EmielV2002/FRDM_MCXx_SensHat/README.md

# FRDM_MCXx_SensHat
 A hat with sensors and actutors for the FRDM-MCXA153 and FRDM-MCXN947 development boards by NXP.
