EmielV2002/FRDM_MCXx_SensHat/PCB/FRDM-MCXA153__Shield__Template-Original/readme.md

# FRDM-MCXA153__Shield__Template
This repo has been initialized with make_pcb.py
## Folder structure 
### /tracks
  Altium & Kicad source files organized by version
### /mixdowns
  Staging area for build documentation organized by version.  The target for the outjob
### /golden
  .zip files with official data for fab organized by version.
