EmielV2002/FRDM_MCXx_SensHat/Docs/Docs V3.x/Orderlist_FRDM-MCXx_Shield_V3.0.xlsx

Type: | Reference: | Value: | Package: | Price pp: | Quantity: | Price total | PCBs: | Price pp: | Total amount: | Extra | Price total: | Link:
Capacitor | C1, C2, C5, C6, C7, C8, C10, C11 | 100nF | 0805 | €0.09 | 9 | €0.84 | 30 | €0.04 | 300 | 0 | €10.50 | https://nl.mouser.com/ProductDetail/KEMET/C0805C104J8RACTU
Capacitor | C3, C4 | 10nF | 0805 | €0.09 | 1 | €0.09 | 30 | €0.05 | 40 | 10 | €2.16 | https://nl.mouser.com/ProductDetail/KEMET/C0805C103K5RACTU
Capacitor | C9 | 10uF | 0805 | €0.09 | 1 | €0.09 | 30 | €0.03 | 40 | 10 | €1.28 | https://nl.mouser.com/ProductDetail/Samsung-Electro-Mechanics/CL21A106KOQNNNF?qs=yOVawPpwOwkT2GN1K0OOyQ%3D%3D
Resistor | R1, R3, R4, R8, R9 | 10k | 0805 | €0.09 | 5 | €0.45 | 30 | €0.01 | 180 | 30 | €1.80 | https://nl.mouser.com/ProductDetail/SEI-Stackpole/RMCF0805FT10K0?qs=IreZ0J%252BReG3LOHc8zdDe6Q%3D%3D
Resistor | R2, R5, R6 | 1k | 0805 | €0.11 | 3 | €0.32 | 30 | €0.01 | 120 | 30 | €0.96 | https://nl.mouser.com/ProductDetail/Kamaya/RMC1-10K1001FTP?qs=JZJGM%252BYuqVpN6T%252B5jtun0w%3D%3D
Resistor | R7 | 470 | 0805 | €0.09 | 1 | €0.09 | 30 | €0.07 | 40 | 10 | €2.92 | https://nl.mouser.com/ProductDetail/Welwyn-Components-TT-Electronics/WCR0805-470RFI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
Diode | D1, D2, D3, D4, D5, D6, D7, D8 | RED | 0805 | €0.18 | 8 | €1.42 | 30 | €0.14 | 300 | 0 | €42.00 | https://nl.mouser.com/ProductDetail/Wurth-Elektronik/150080RS75000?qs=LlUlMxKIyB2jdCo7bnfgew%3D%3D
Diode | D9, D10, D11, D12, D13 | SP0503BAHT | SOT-143 | €0.61 | 5 | €3.07 | 30 | €0.42 | 180 | 30 | €75.42 | https://nl.mouser.com/ProductDetail/Littelfuse/SP0503BAHTG?qs=uD%2FdkN7XIa0NTYXwHdELYA%3D%3D
Diode | D14, D15, D16 | SK6812 | SK6812_PLCC4_5.0x5.0mm_P3.2mm | €0.42 | 3 | €1.26 | 30 | €0.42 | 100 | 10 | €41.90 | https://nl.mouser.com/ProductDetail/Adafruit/1655?qs=GURawfaeGuATdkjqVQs49g%3D%3D
IC | U1 | 74HC595 | TSSOP-16 | €0.35 | 1 | €0.35 | 30 | €0.26 | 40 | 10 | €10.44 | https://nl.mouser.com/ProductDetail/Nexperia/74HC595PW-Q100118?qs=1sbE9T7hb3aHrTORCcEuDg%3D%3D
IC | U2 | M95010-RMN6TP | SOIC-8 | €0.26 | 1 | €0.26 | 30 | €0.24 | 40 | 10 | €9.52 | https://nl.mouser.com/ProductDetail/STMicroelectronics/M95010-RMN6TP?qs=6hSH1YZbOIgK0xa%252BHaDUCw%3D%3D
IC | U3 | LM35-D | SOIC-8 | €2.22 | 1 | €2.22 | 30 | €1.40 | 40 | 10 | €56.00 | https://nl.mouser.com/ProductDetail/Texas-Instruments/LM35DMX-NOPB?qs=QbsRYf82W3EWENRCd3%252BcOw%3D%3D
Switch | SW1 | EC12D1524406 | EC12D1564404 | €1.92 | 1 | €1.92 | 30 | €1.63 | 40 | 10 | €65.20 | https://nl.mouser.com/ProductDetail/Alps-Alpine/EC12D1524406?qs=YMSFtX0bdJBTxNo8FqqMqg%3D%3D
Test hook | TP1, TP2, TP3, TP4, TP5, TP6 | 5001 | 5000 | €0.34 | 6 | €2.06 | 30 | €0.27 | 190 | 10 | €51.30 | https://nl.mouser.com/ProductDetail/Keystone-Electronics/5001?qs=q0tsjPZWdm%2FW0vdr%2FwowKg%3D%3D
Resistor | RN2, RN3 | 1k | 4X1206 | €0.39 | 2 | €0.78 | 30 | €0.17 | 70 | 10 | €11.97 | https://nl.mouser.com/ProductDetail/YAGEO/YC324-FK-071KL?qs=Yg3NzgXT575QDUkzeq0DWw%3D%3D
Resistor | RN1 | 4,7k | 4X1206 | €0.42 | 1 | €0.42 | 30 | €0.17 | 40 | 10 | €6.60 | https://nl.mouser.com/ProductDetail/YAGEO/YC324-JK-074K7L?qs=8cPjvKtxWv6TVoP8DHxSjw%3D%3D
Oled | SSD1306 | SSD1306 | - | €7.00 | 1 | €7.00 | 30 | €6.00 | 35 | 5 | €210.00 | https://www.tinytronics.nl/en/displays/oled/0.96-inch-oled-display-128*64-pixels-white-i2c
Total: |  |  |  | €14.69 | 50 | €22.65 | 30 |  | 1500 |  | €599.97
 | Let op!: SK6182 worden per 10 verpakt. Het gaat hier om 3 leds, niet 3 verpakkingen!
Prijs per pcb | €22.65
Prijs 30 pcbs | €20.00
