EmielV2002/FRDM_MCXx_SensHat/Solder stencil tool/tool assem.SLDASM

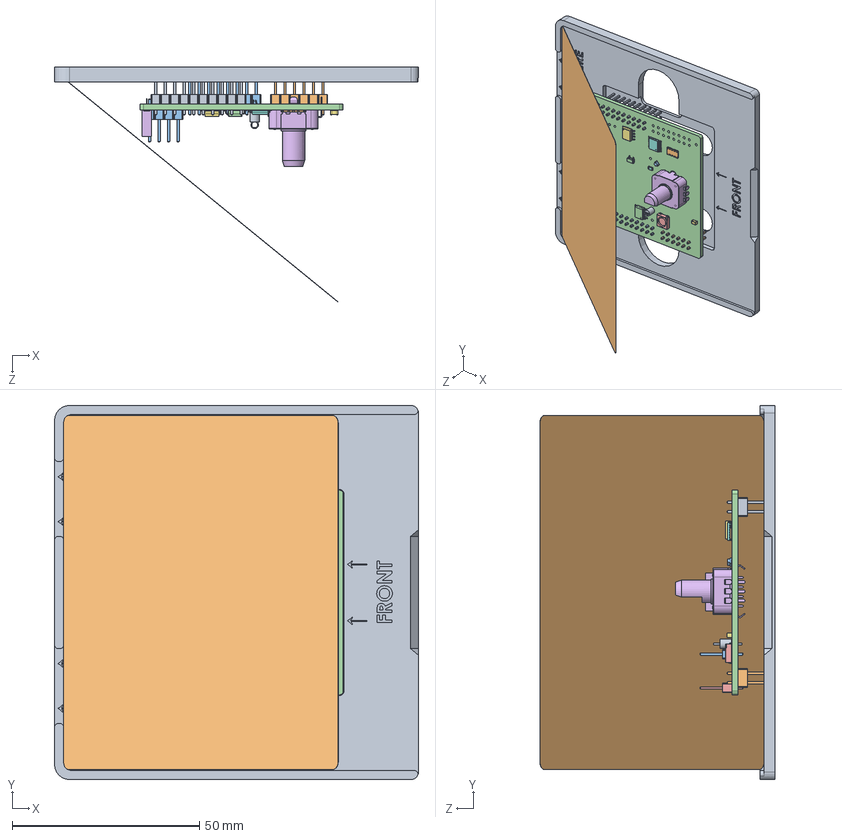
[picture p1: CAD file, 2024-06-22]
Solder stencil tool/tool assem.SLDASM
97.3 x 100.0 x 62.9 mm
Tool
Stencil
FRDM-MCXx_Shield_V3.0_PCB.step
