EmielV2002/FRDM_MCXx_SensHat/PCB/3D/3386P.step

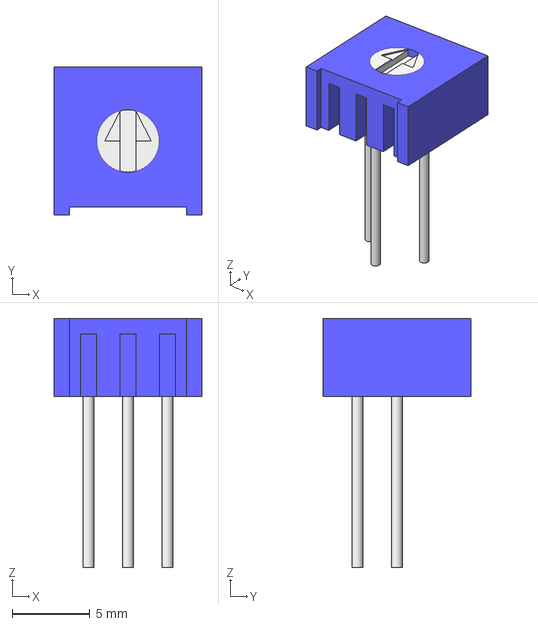
[picture p2: CAD file, 2024-06-17]
PCB/3D/3386P.step
9.50 x 9.50 x 16.0 mm
