EmielV2002/FRDM_MCXx_SensHat/PCB/3D/Rotary Encoder.step

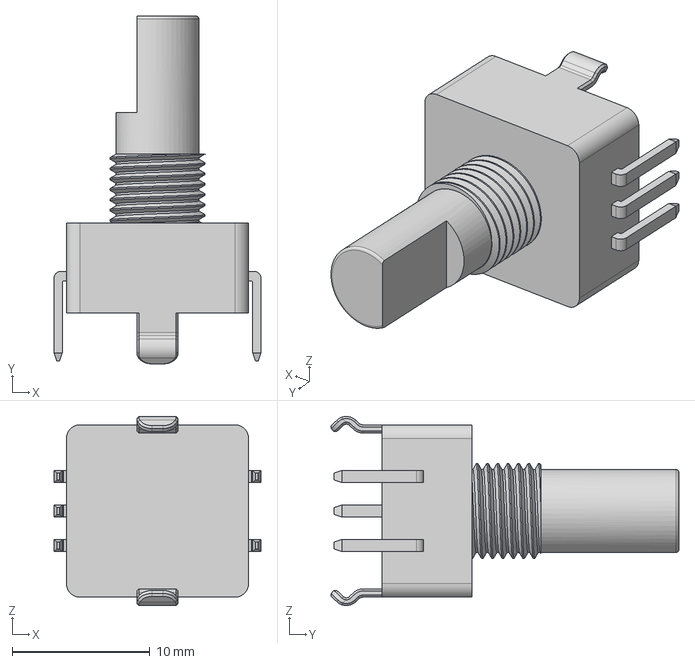
[picture p3: CAD file, 2024-06-17]
PCB/3D/Rotary Encoder.step
15.0 x 25.2 x 13.7 mm
