EmielV2002/FRDM_MCXx_SensHat/Solder stencil tool/Stencil.SLDPRT

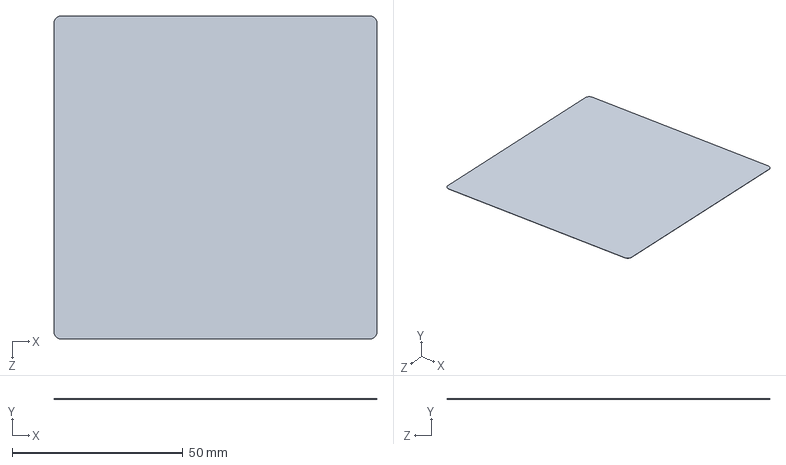
[picture p4: CAD file, 2024-06-20]
Solder stencil tool/Stencil.SLDPRT
94.7 x 0.1 x 94.7 mm
