EmielV2002/FRDM_MCXx_SensHat/PCB/3D/SHT31_DFN8.stp

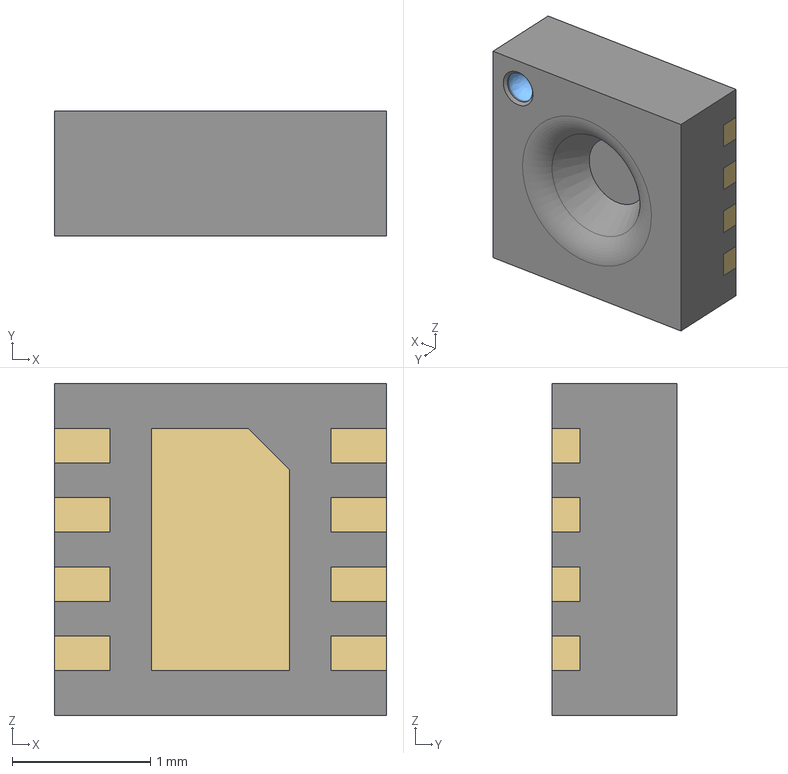
[picture p5: CAD file, 2024-06-17]
PCB/3D/SHT31_DFN8.stp
2.40 x 0.9 x 2.40 mm
