EmielV2002/FRDM_MCXx_SensHat/Solder stencil tool/Tool.SLDPRT

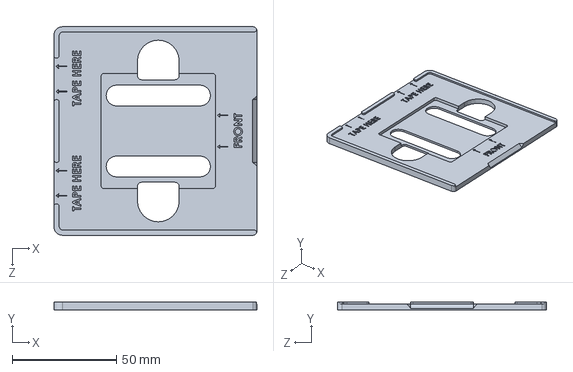
[picture p6: CAD file, 2024-06-20]
Solder stencil tool/Tool.SLDPRT
97.3 x 4.00 x 100.0 mm
