EmielV2002/FRDM_MCXx_SensHat/(list of files, cad)

Other CAD files:
Solder stencil tool/Tool.STL
