EmielV2002/FRDM_MCXx_SensHat/Docs/Docs V3.x/hardware diagram V3.x.drawio.pdf

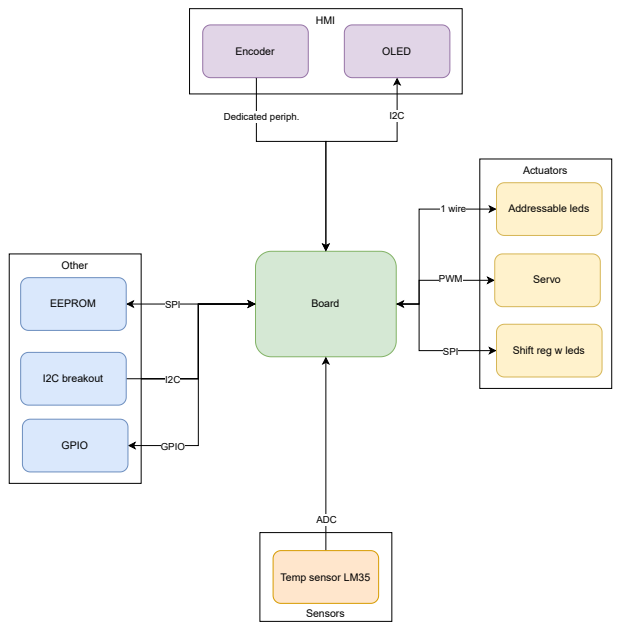
[picture p8: page 1]
HMI; Sensors; Actuators; 1 wire; PWM; Board; ADC; Temp sensor LM35; Addressable leds; OLED; Dedicated periph.; Encoder; SPI; Shift reg w leds; Other; EEPROM; GPIO; Servo; I2C breakout
