EmielV2002/FRDM_MCXx_SensHat/PCB/FRDM-MCXA153__Shield__Template-Original/mixdowns/A/SCH/CCA-10010__SCHEMATICS__A.PDF

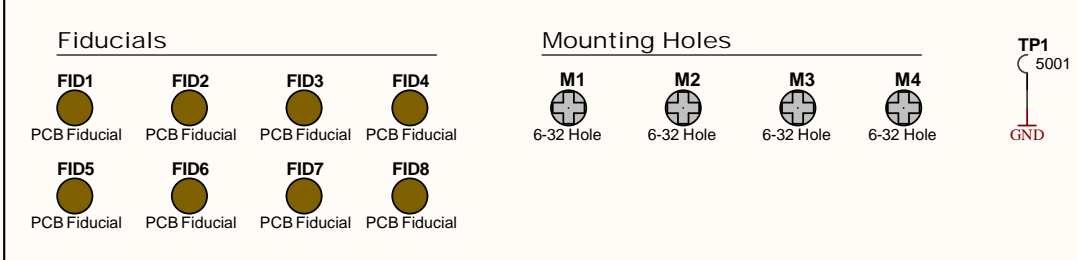
[picture p9: page 1]

Part Numbe r PCB-10010 | PCB Mixdown A | CCA Mixdown
De s cription FR DM-MCXA153__Shield__T e m p l a t e | 3A Date 2023-12-2 6

Engine e r Plexu s | Page 1 o f

TODO:
Add license/copyright symbol here
