EmielV2002/FRDM_MCXx_SensHat/Docs/FRDM-MCXAorN_Hat.drawio.pdf

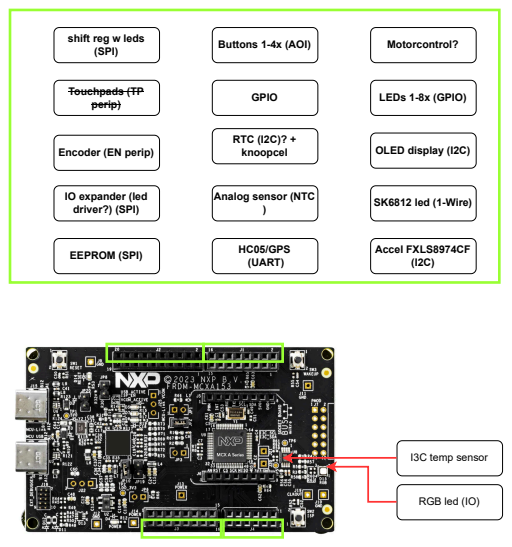
[picture p10: page 1]
I3C temp sensor; OLED display (I2C); SK6812 led (1-Wire); HC05/GPS (UART); Accel FXLS8974CF (I2C); GPIO; LEDs 1-8x (GPIO); Buttons 1-4x (AOI); Motorcontrol? shift reg w leds; (SPI); Touchpads (TP perip); EEPROM (SPI); RTC (I2C)? + knoopcel

Encoder (EN perip)

IO expander (led
driver?) (SPI)

Analog sensor (NTC

RGB led (IO)
