EmielV2002/FRDM_MCXx_SensHat/Docs/Docs V3.x/FRDM-MCXx_Shield_V3.0.pdf

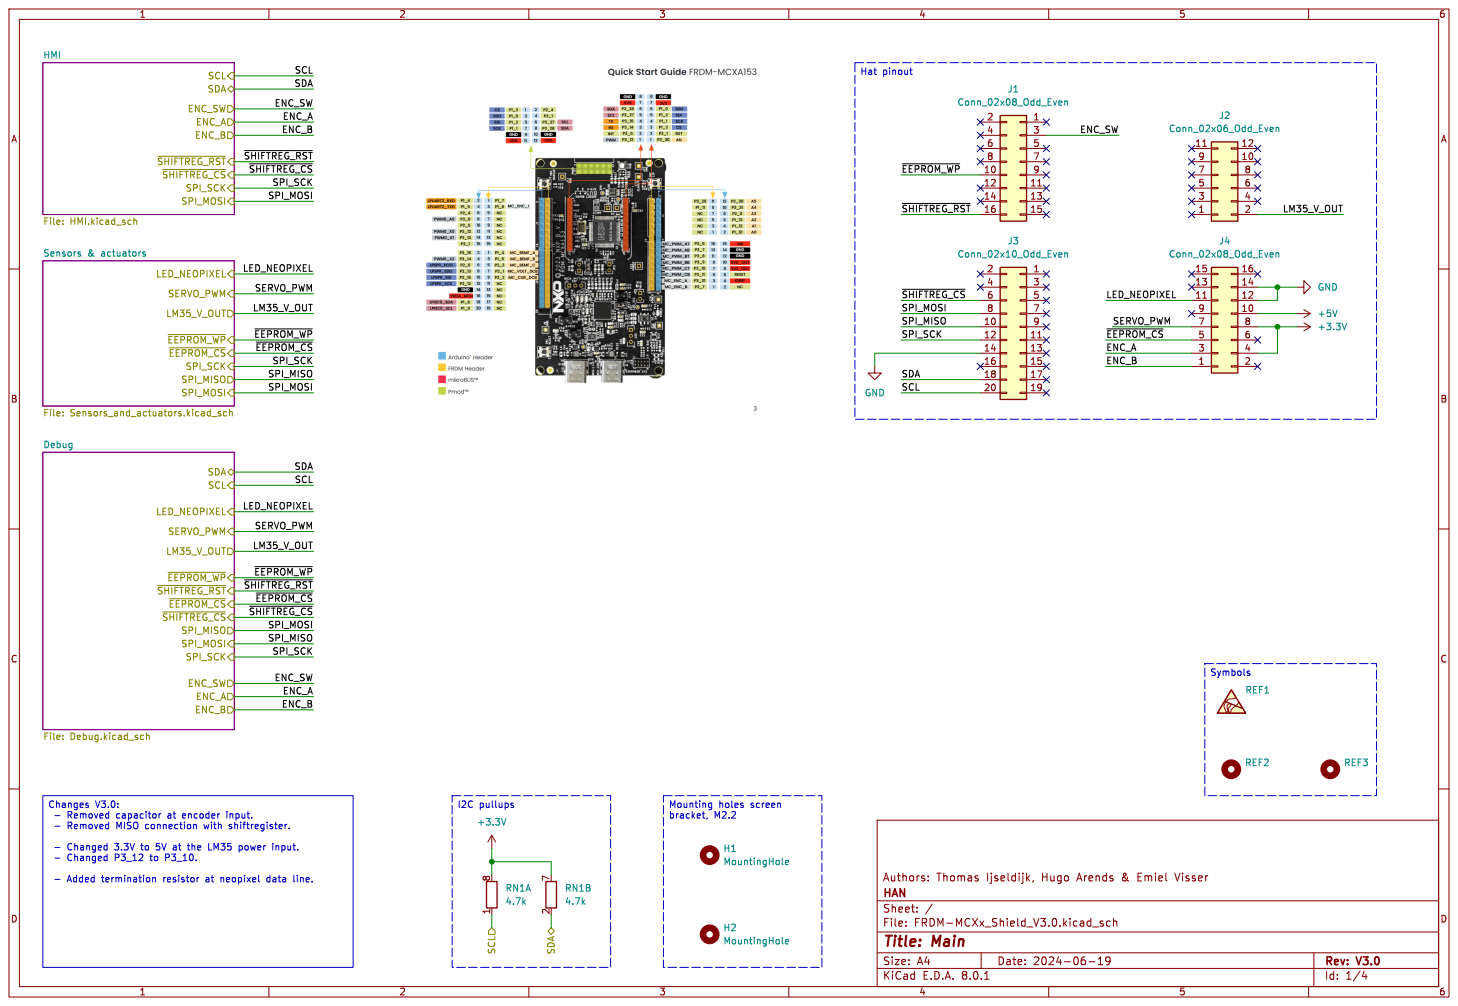
[picture p11: page 1]

File: FRDM-MCXx_Shield_V3.0.kicad_sch Sheet: / HAN

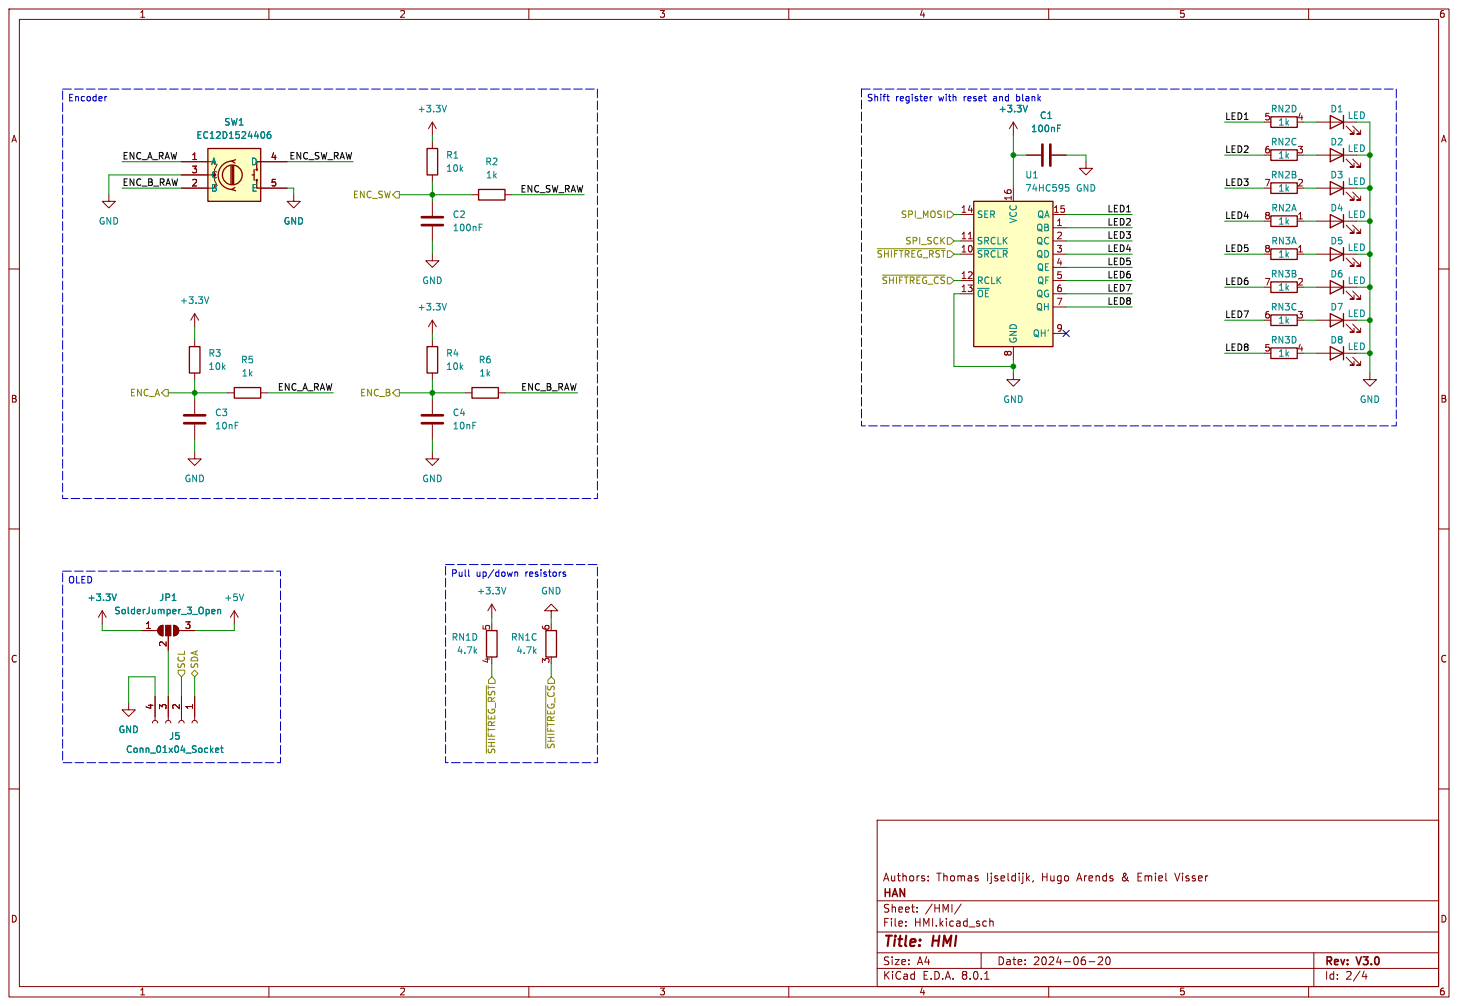
[picture p12: page 2]

Id: 2/4 Title: HMI File: HMI.kicad_sch Sheet: /HMI/ HAN

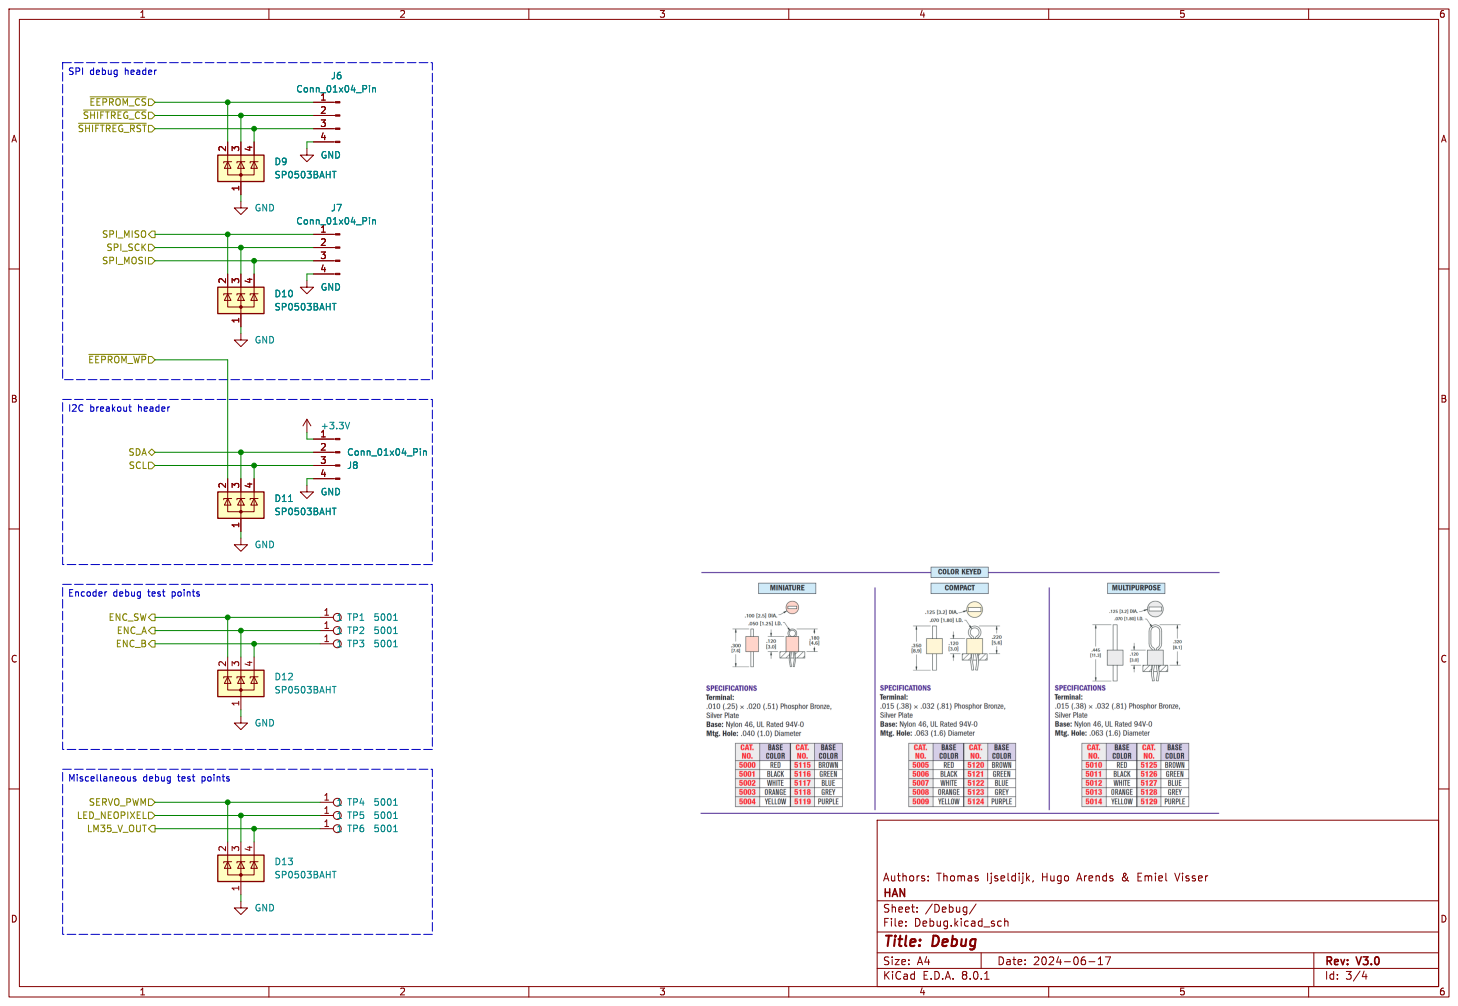
[picture p13: page 3]

File: Debug.kicad_sch Sheet: /Debug/ HAN

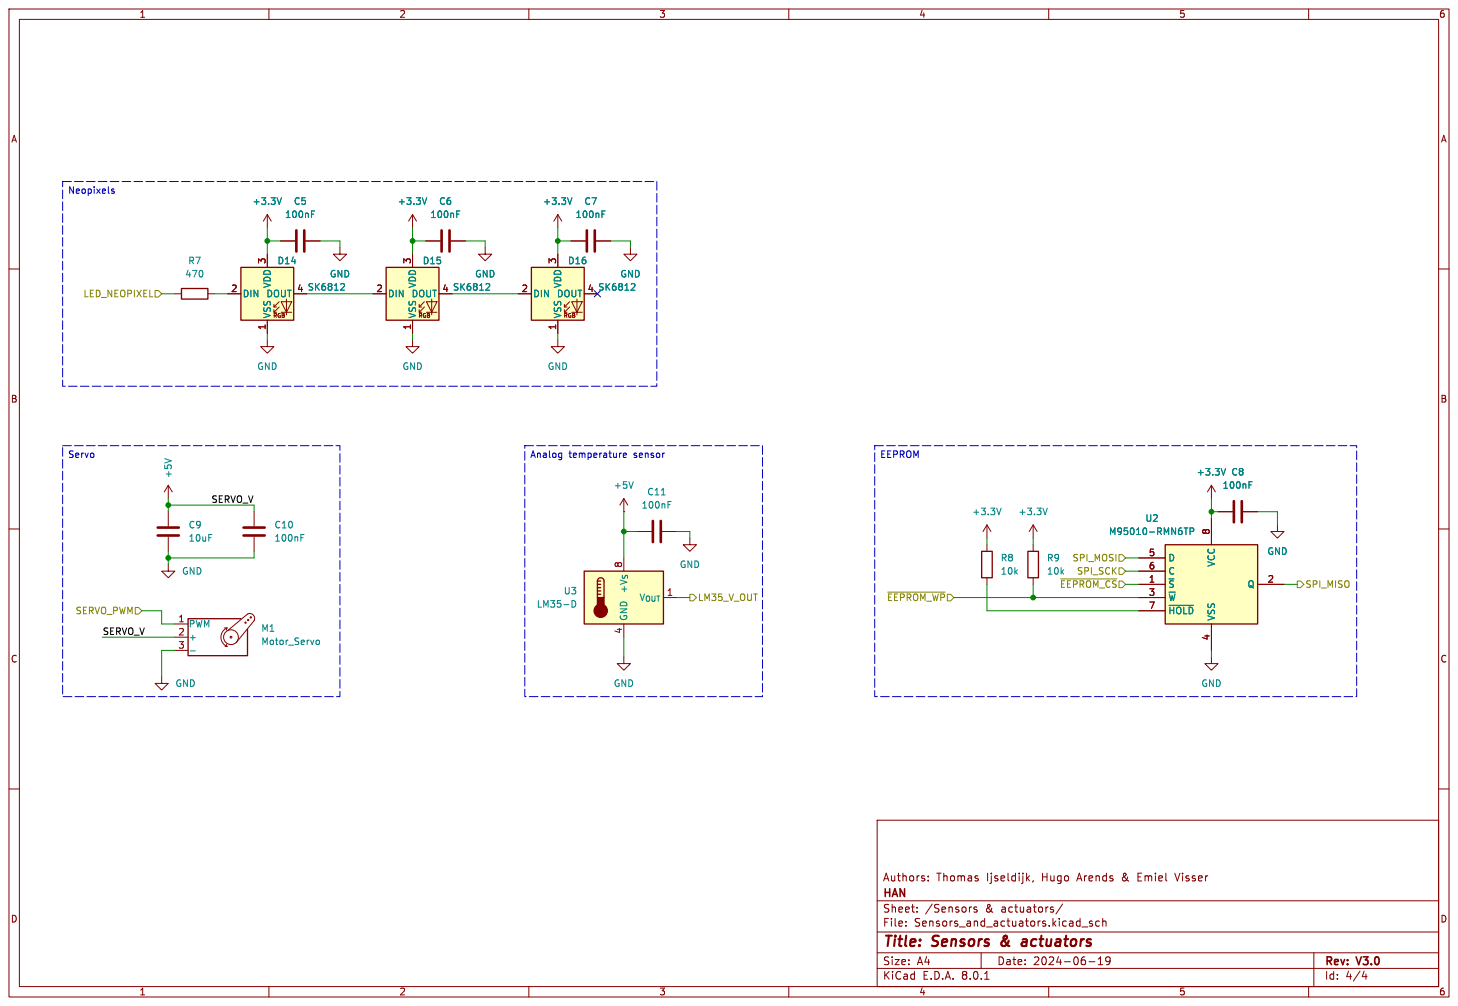
[picture p14: page 4]

8 U2 M95010-RMN6TP VSS RGB 1 DIN 2 VDD

Id: 4/4 Title: Sensors & actuators
