EmielV2002/FRDM_MCXx_SensHat/Docs/Docs V1.x/hardware diagram V1.x.drawio.pdf

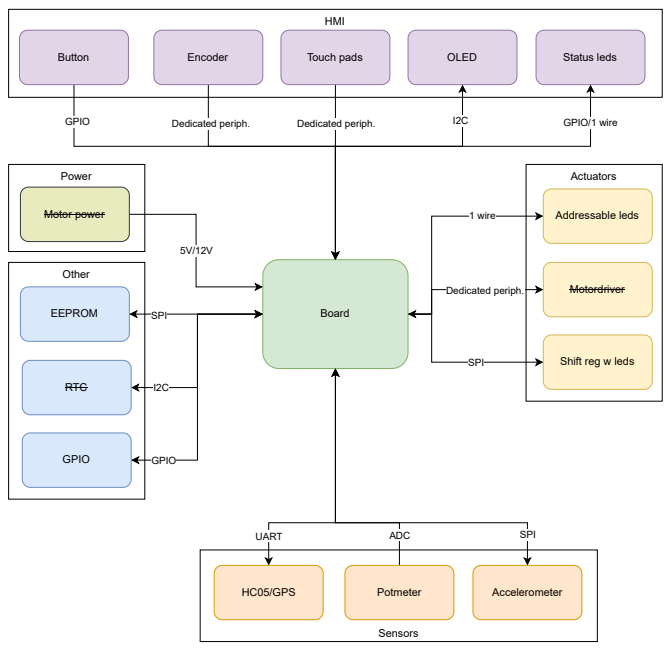
[picture p15: page 1]
HMI; Power; Sensors; Actuators; GPIO/1 wire; 1 wire; Dedicated periph.; Board; Status leds; ADC; Potmeter; Addressable leds; GPIO; Button; Motor power; Motordriver; OLED; Encoder; Touch pads; SPI; Accelerometer; Shift reg w leds; UART; HC05/GPS; Other; EEPROM; RTC
