EmielV2002/FRDM_MCXx_SensHat/Docs/Docs V1.x/FRDM-MCXx_Shield feedback Hugo 1.pdf

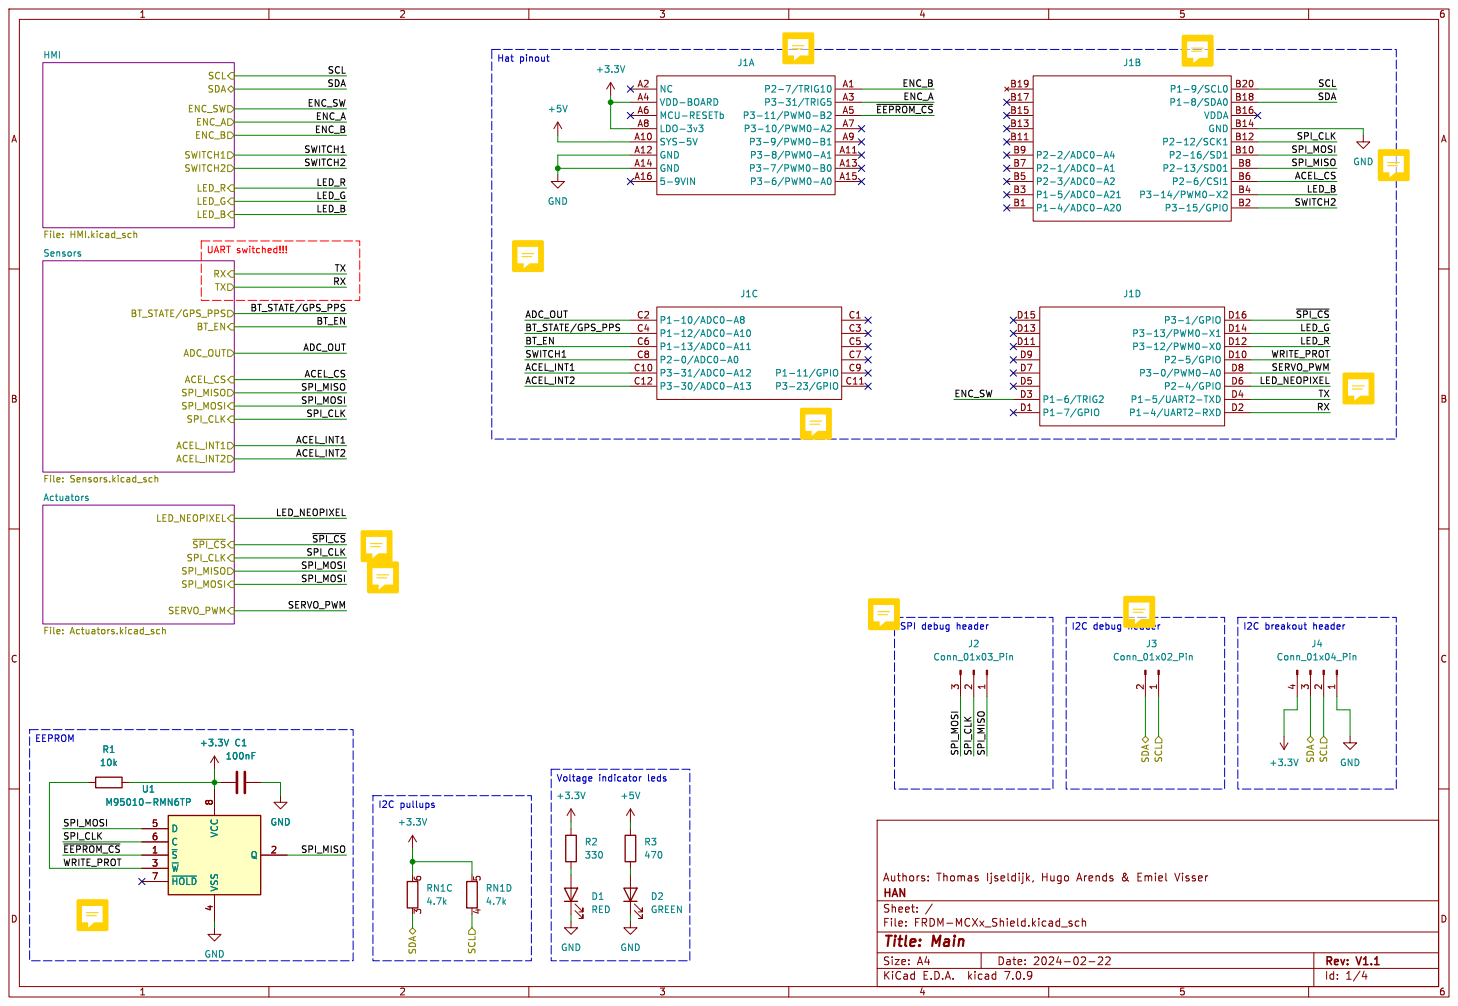
[picture p16: page 1]

File: FRDM-MCXx_Shield.kicad_sch Sheet: / HAN

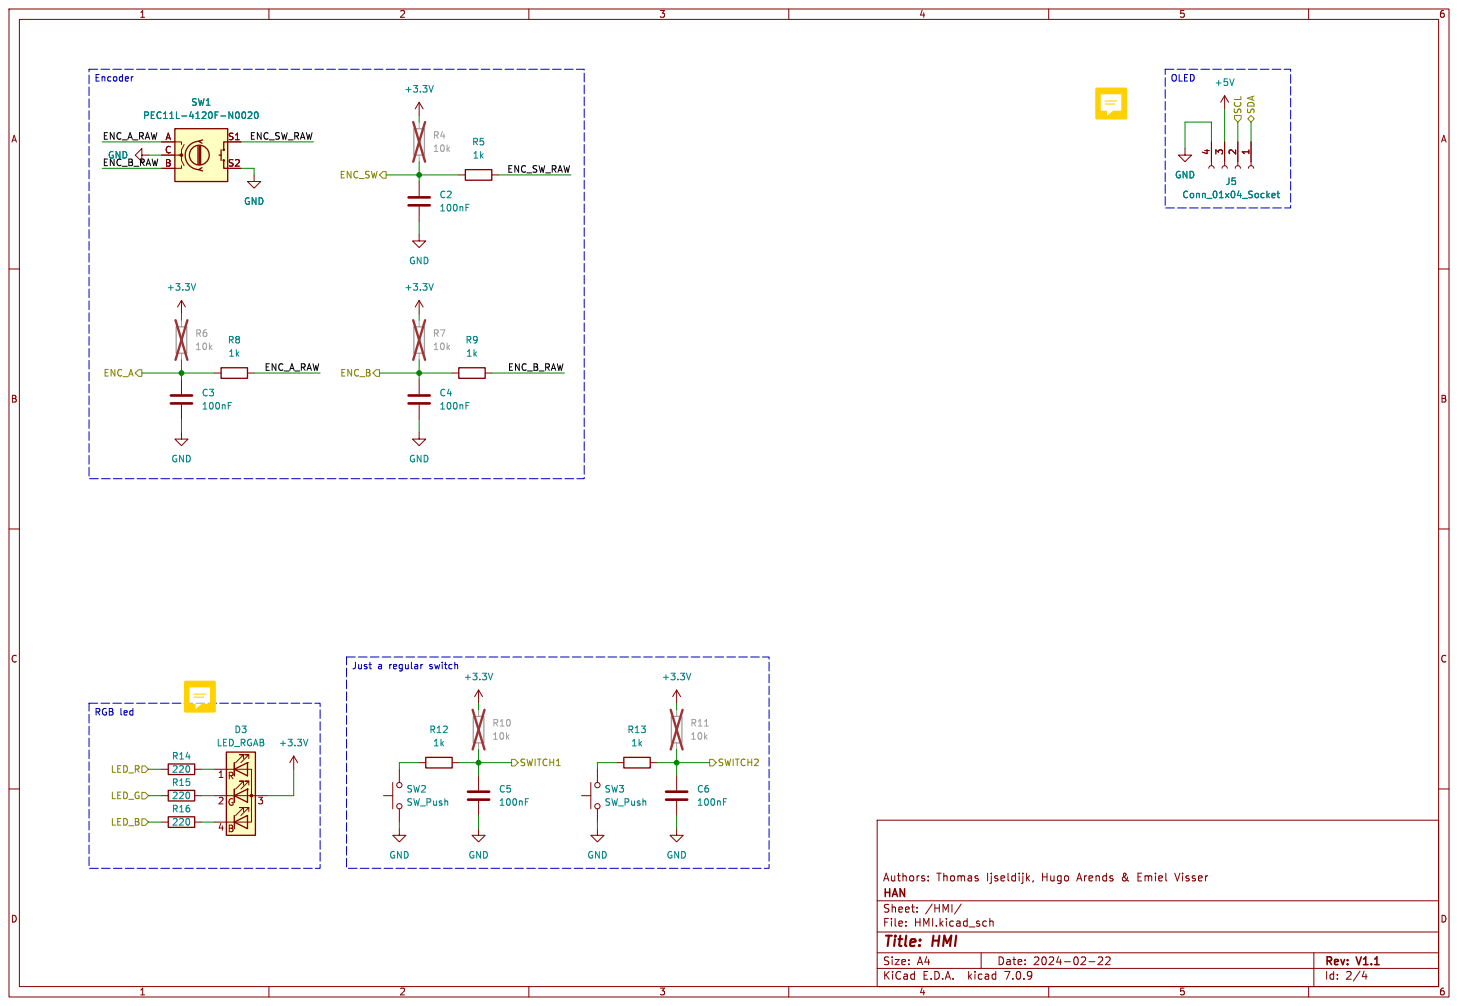
[picture p17: page 2]

Id: 2/4 Title: HMI File: HMI.kicad_sch Sheet: /HMI/ HAN

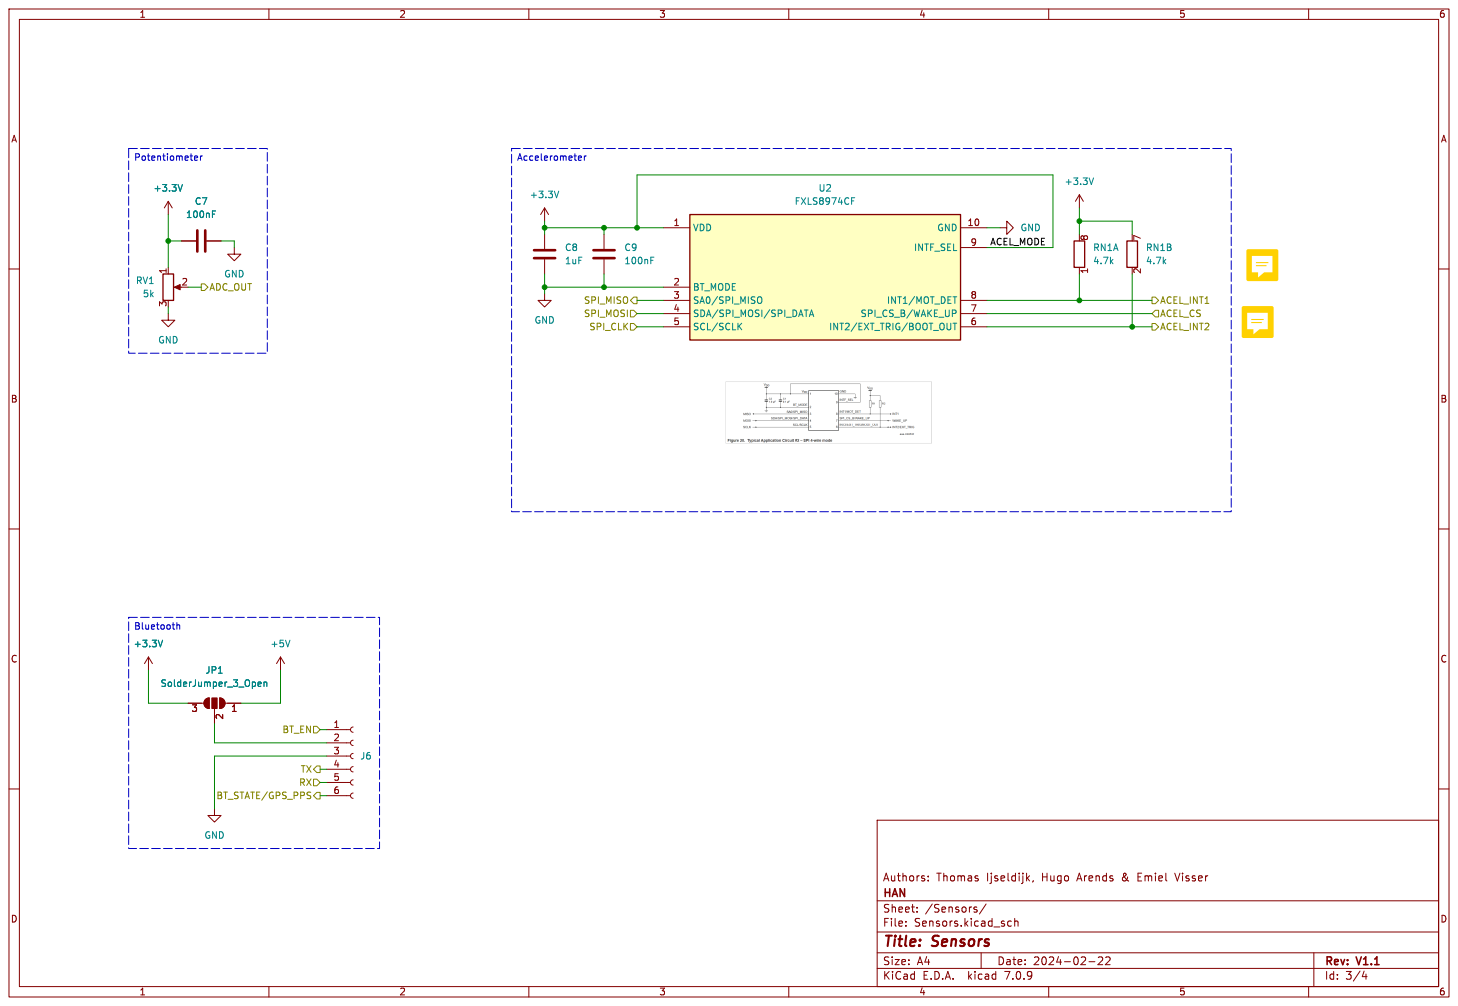
[picture p18: page 3]

File: Sensors.kicad_sch Sheet: /Sensors/ HAN

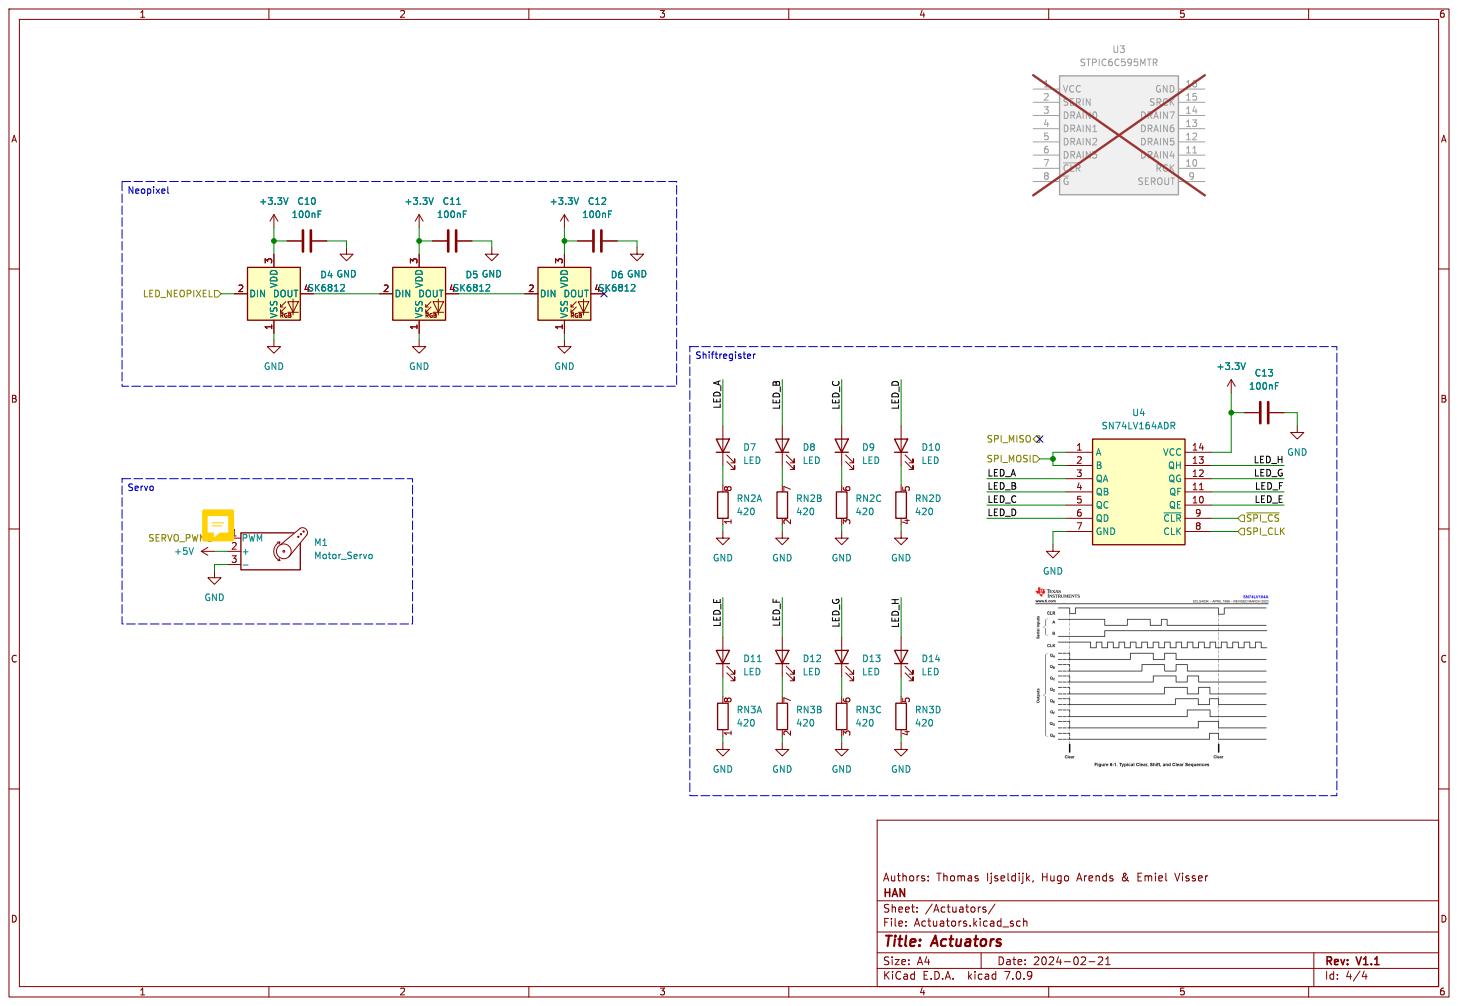
[picture p19: page 4]

File: Actuators.kicad_sch Sheet: /Actuators/ HAN
