EmielV2002/FRDM_MCXx_SensHat/Docs/Docs V1.x/FRDM-MCXx_Shield.pdf

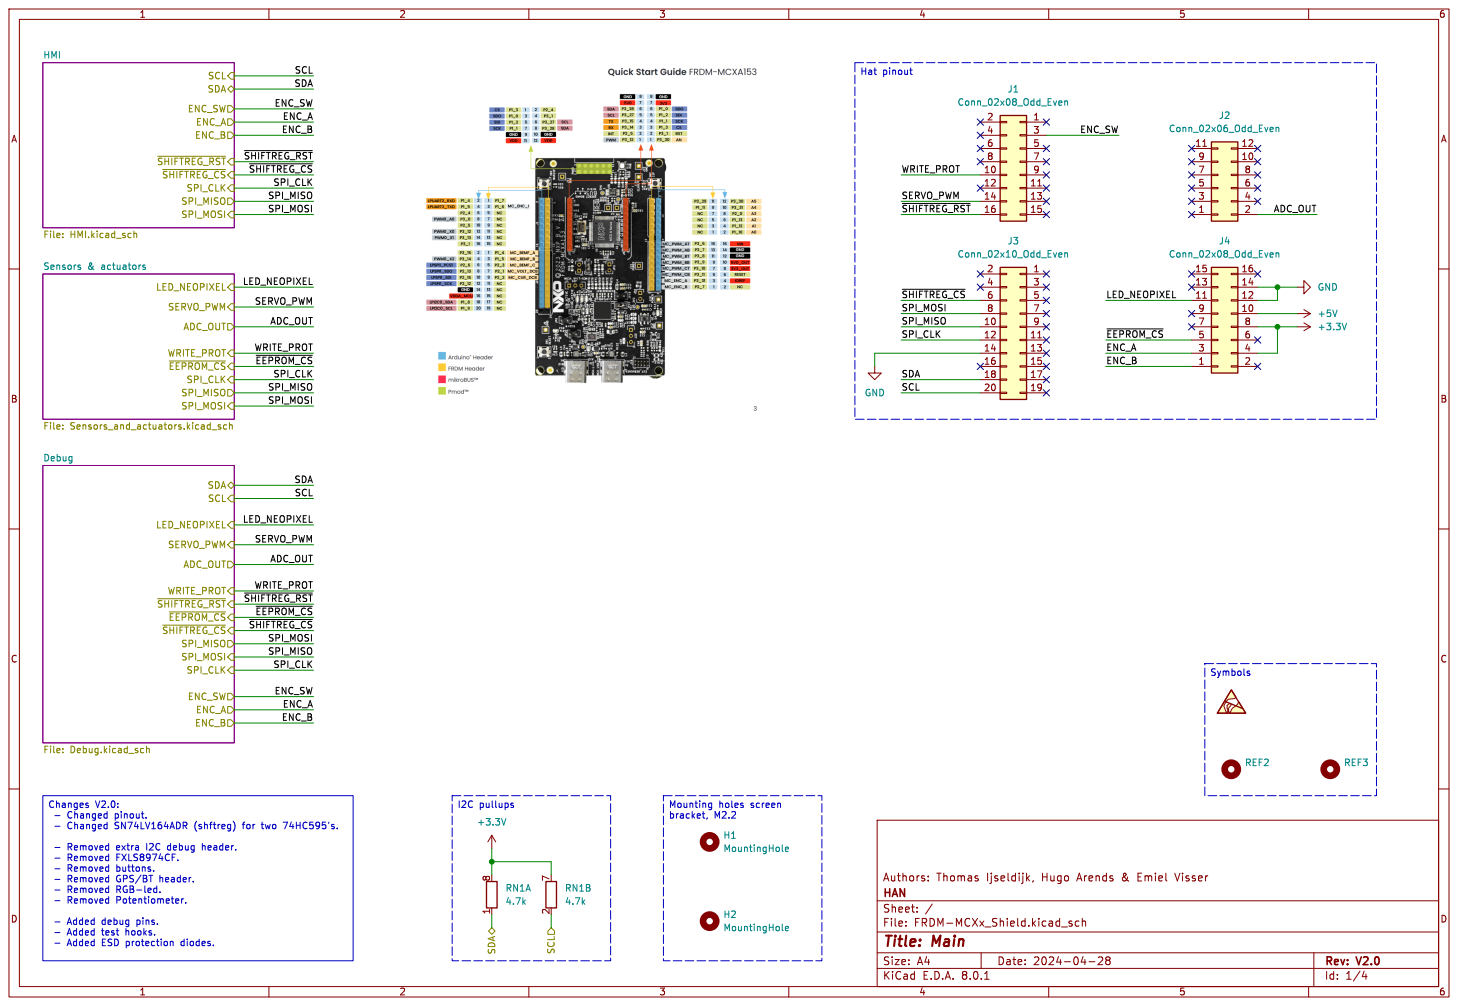
[picture p20: page 1]

Sensors & actuators File: Sensors_and_actuators.kicad_schSCL SDA

File: FRDM-MCXx_Shield.kicad_sch Sheet: / HAN

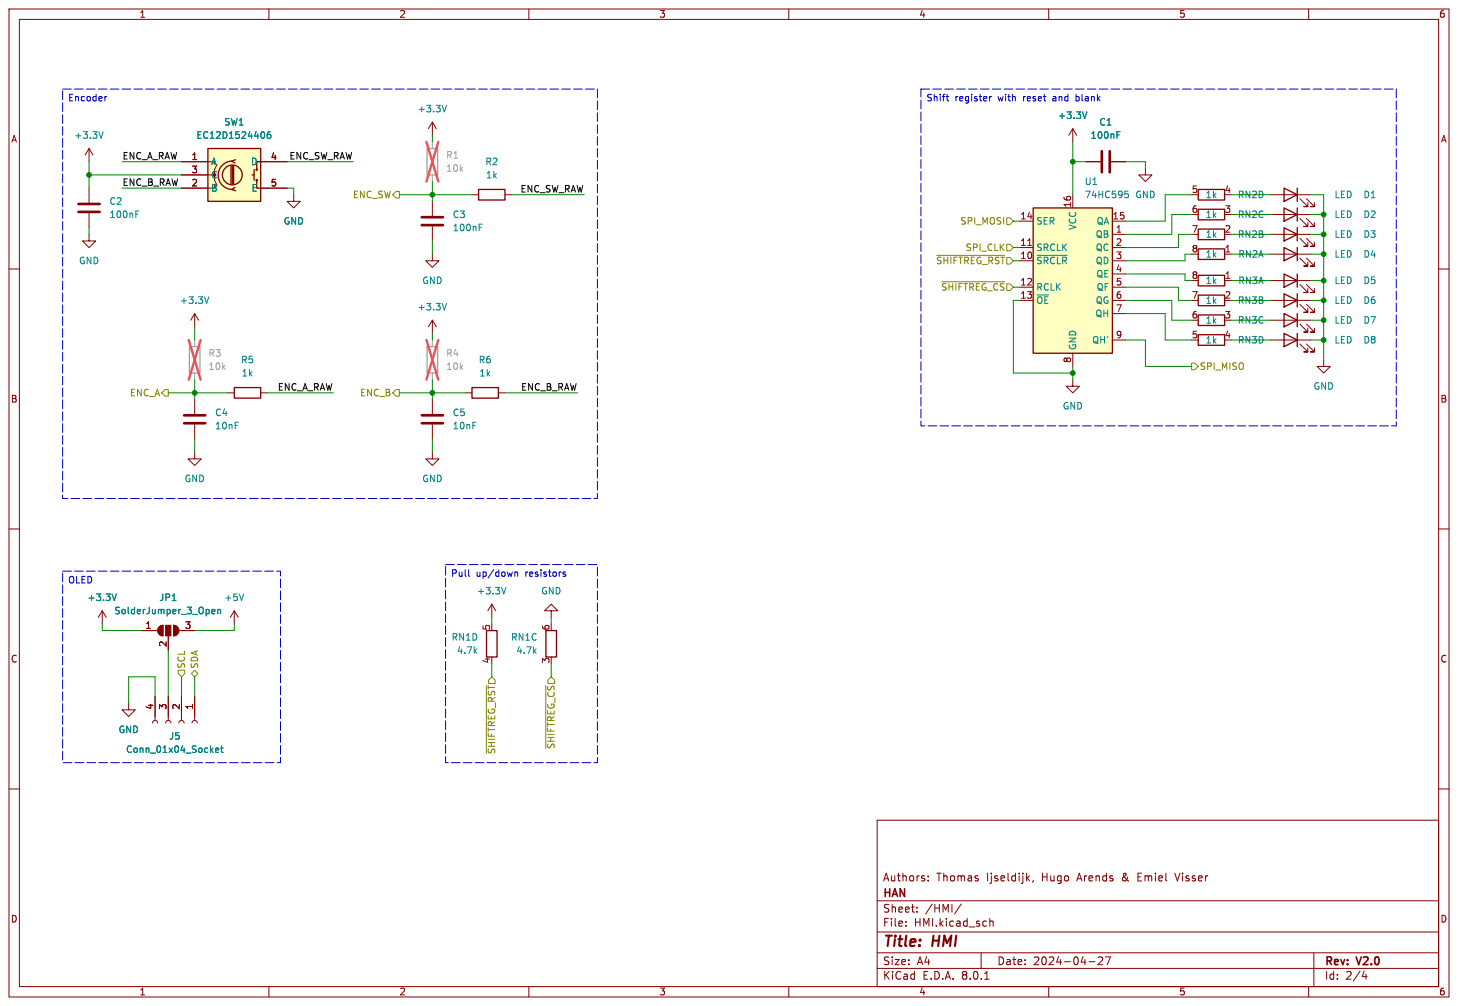
[picture p21: page 2]

Id: 2/4 Title: HMI File: HMI.kicad_sch Sheet: /HMI/ HAN

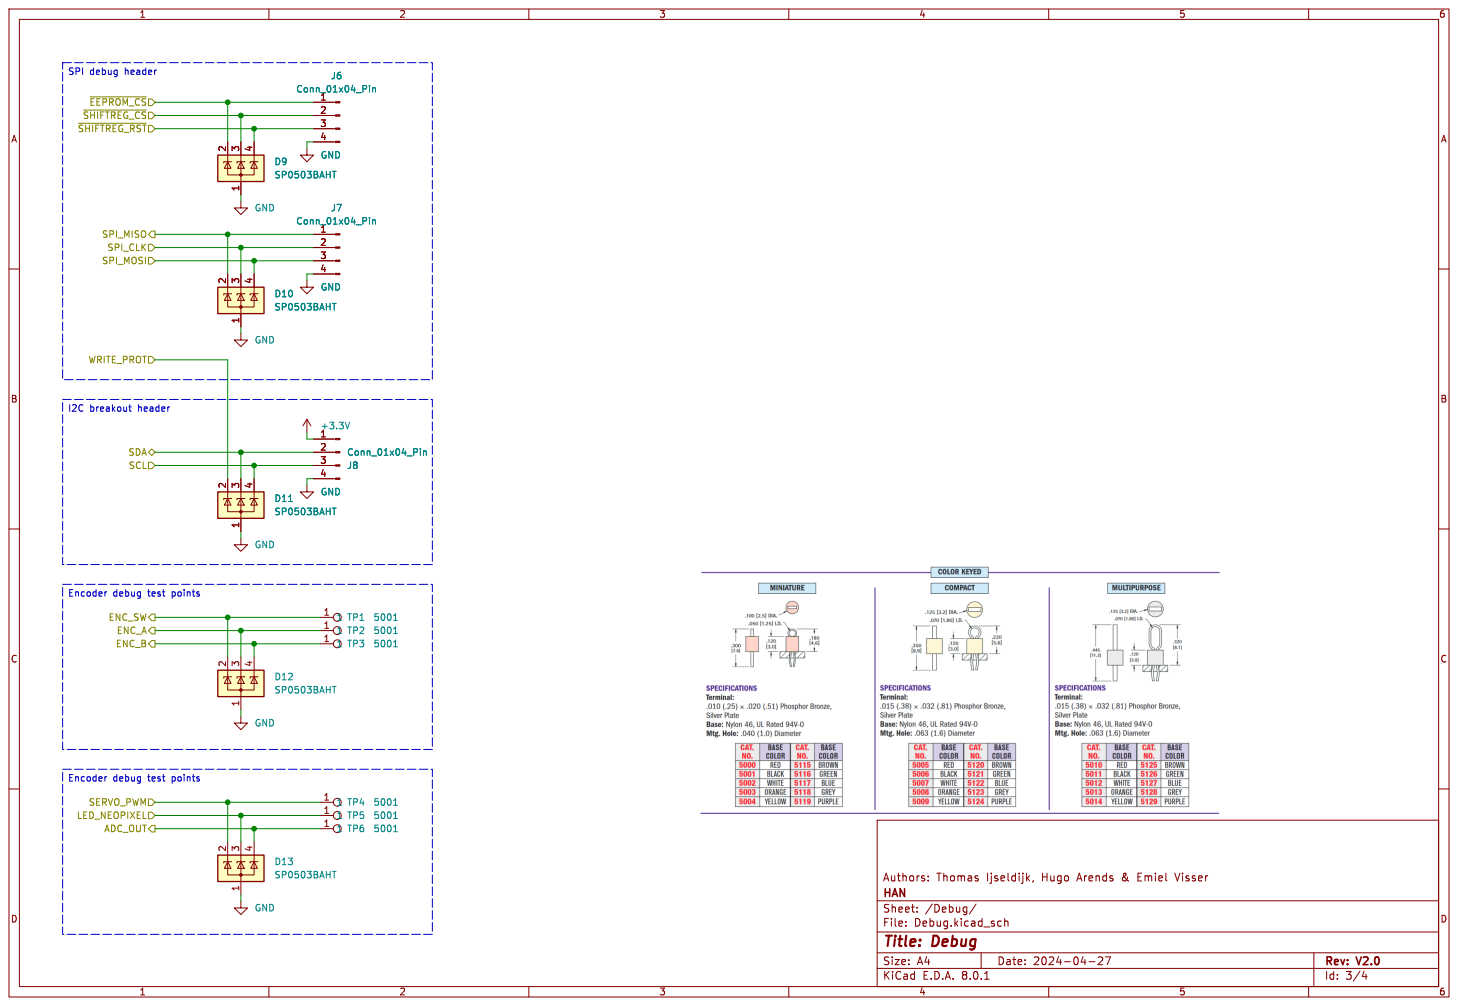
[picture p22: page 3]

Encoder debug test points

File: Debug.kicad_sch Sheet: /Debug/ HAN

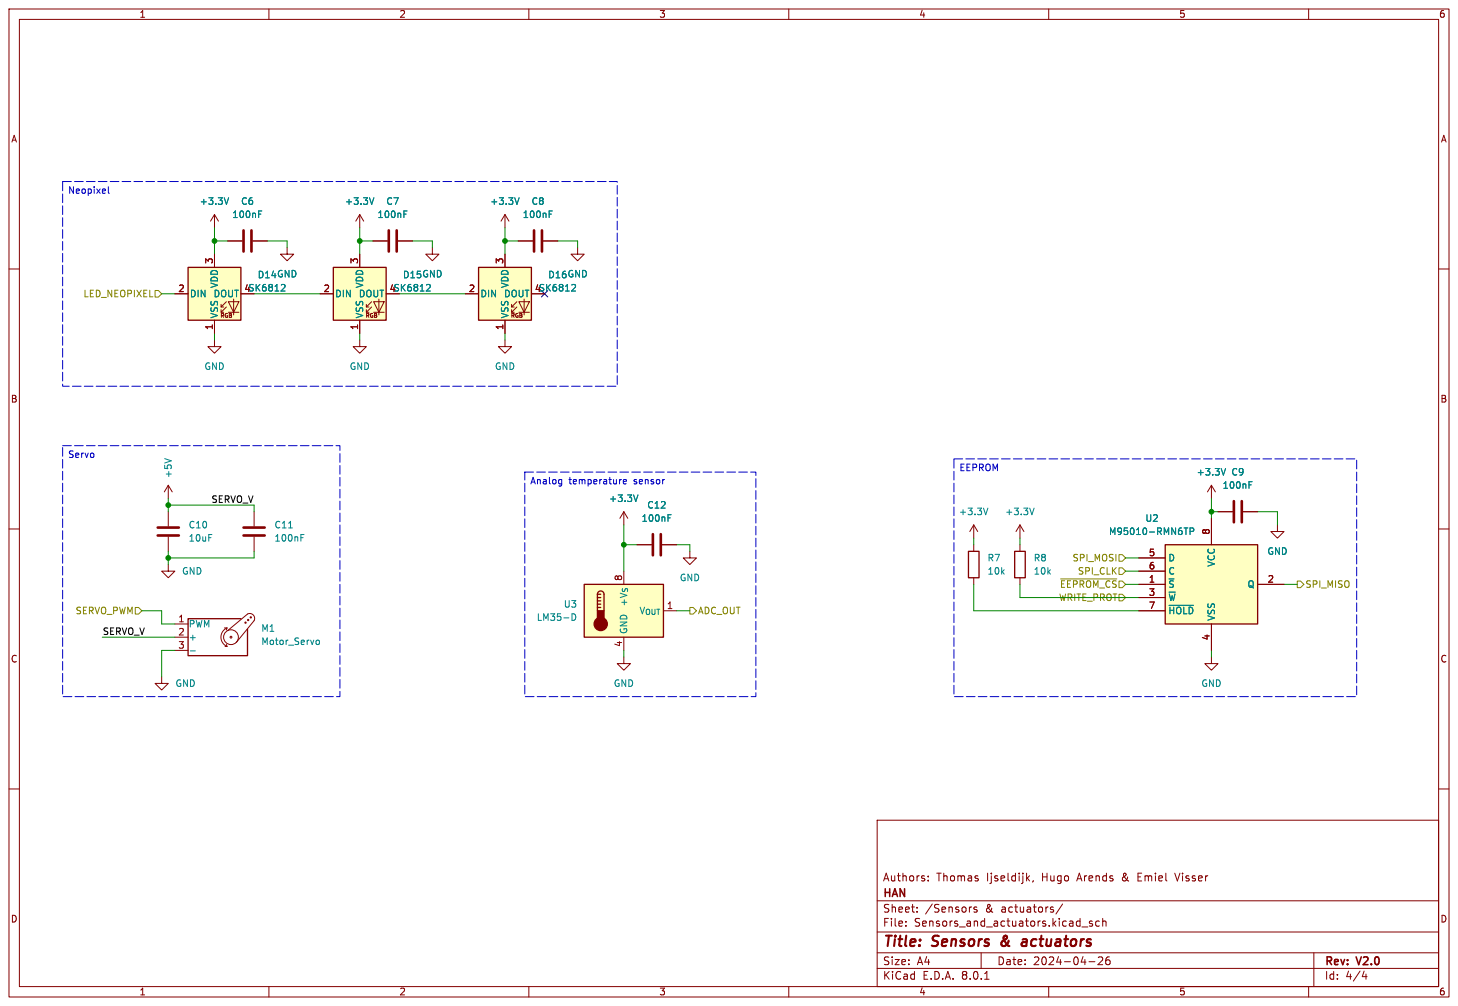
[picture p23: page 4]

3 DOUT 4 D15 SK6812 +3.3V GND VSS RGB 1 DIN 2 VDD

Id: 4/4 Title: Sensors & actuators
