EmielV2002/FRDM_MCXx_SensHat/Docs/Docs V1.x/FRDM-MCXx_Shield_V1.1.pdf

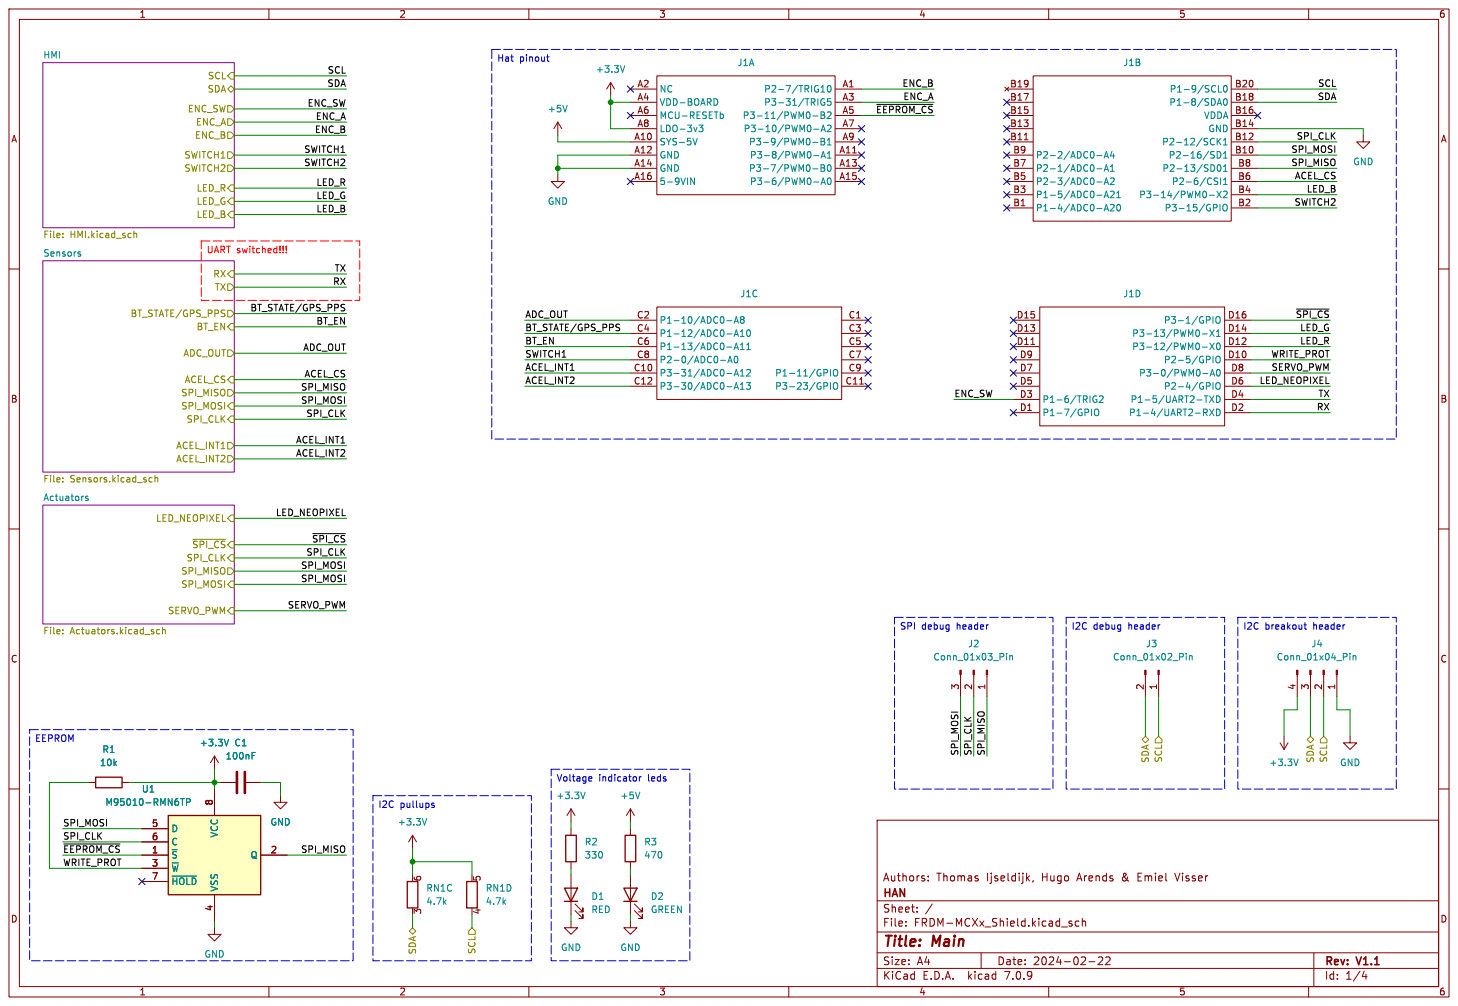
[picture p24: page 1]

File: FRDM-MCXx_Shield.kicad_sch Sheet: / HAN

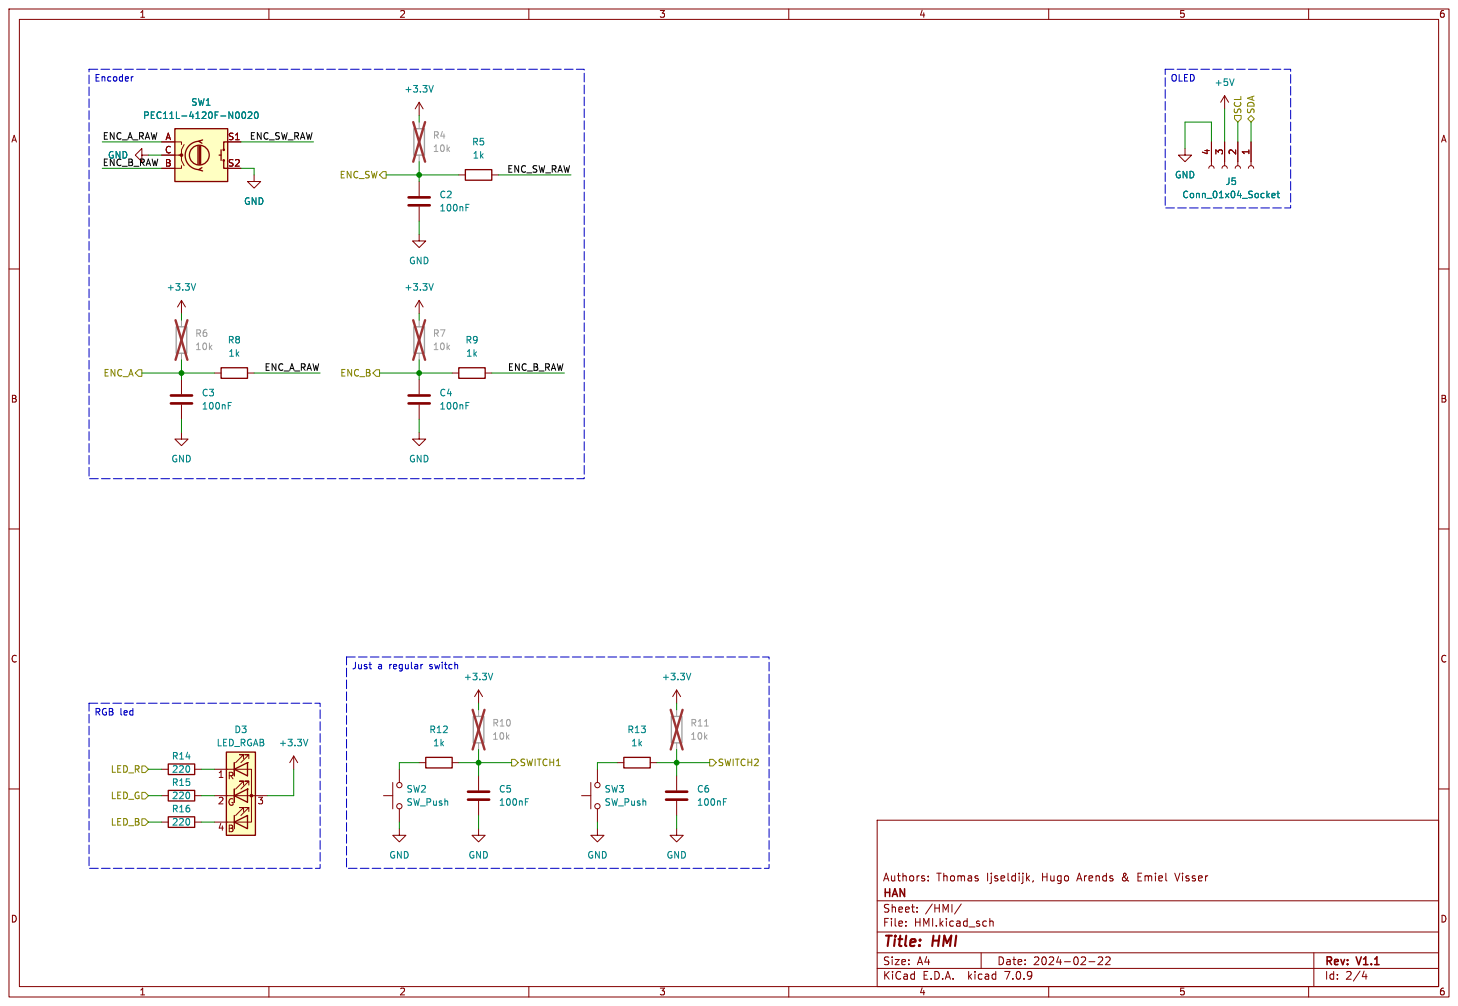
[picture p25: page 2]

Id: 2/4 Title: HMI File: HMI.kicad_sch Sheet: /HMI/ HAN

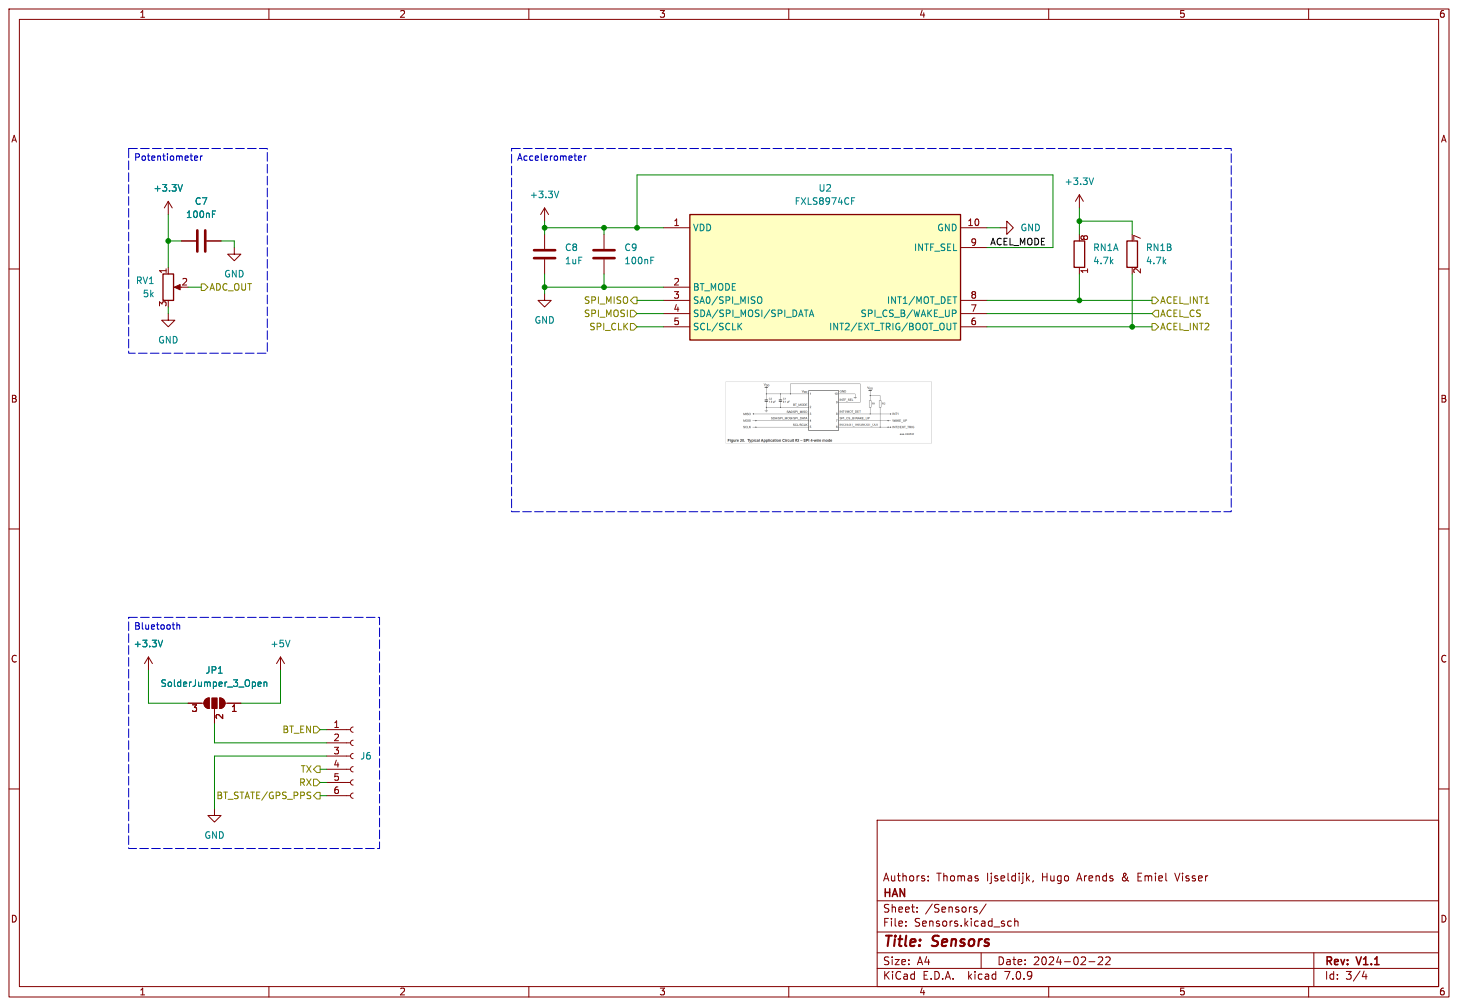
[picture p26: page 3]

File: Sensors.kicad_sch Sheet: /Sensors/ HAN

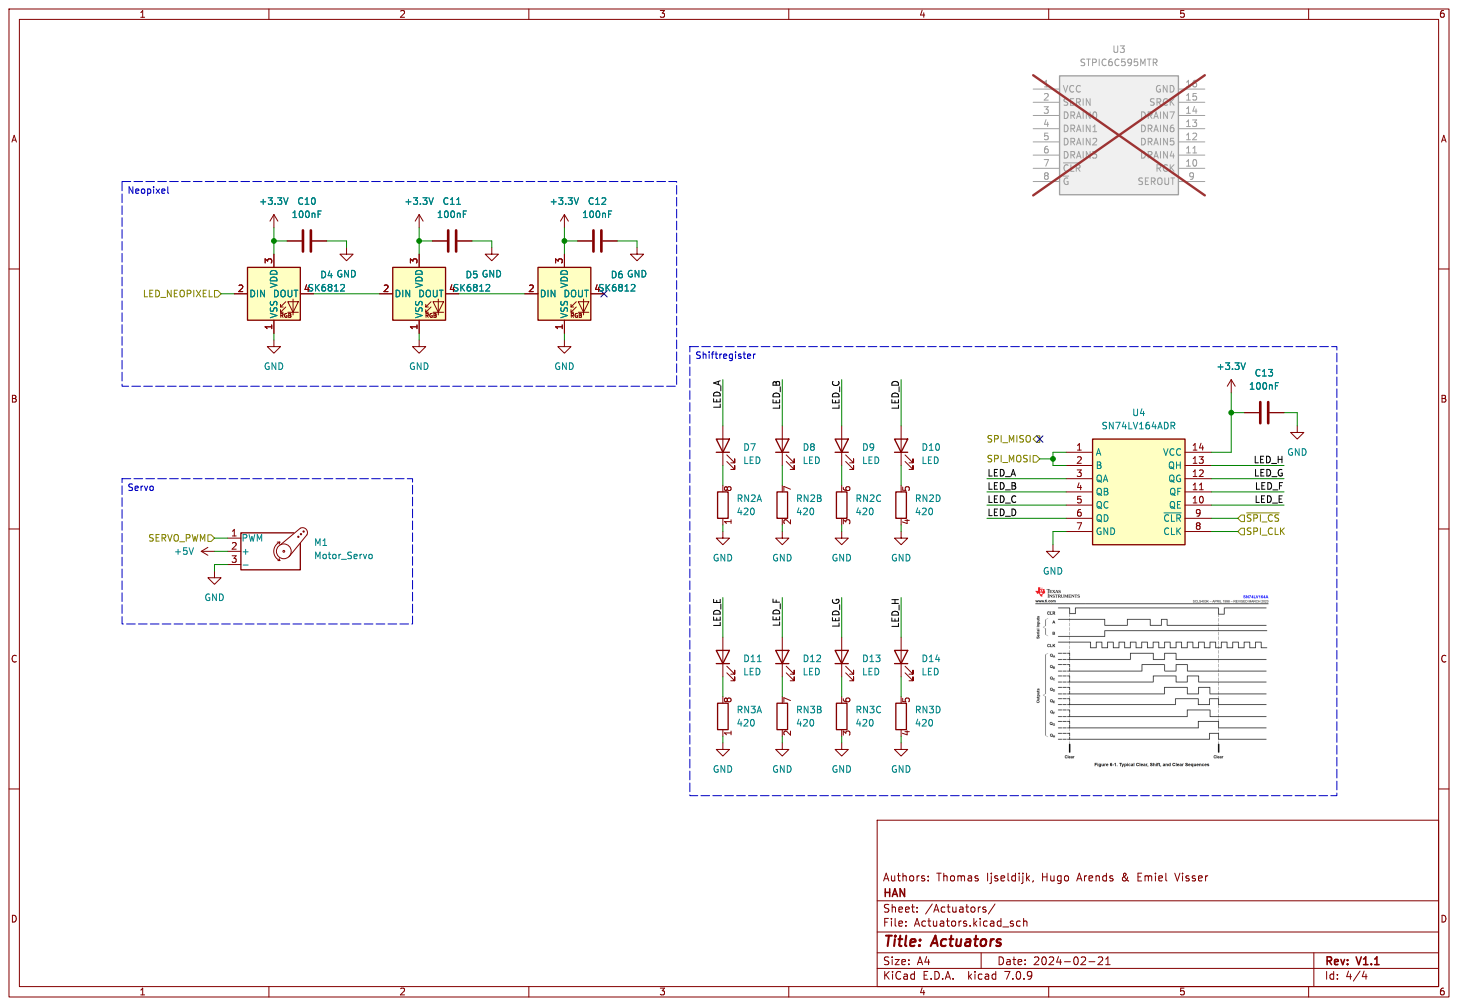
[picture p27: page 4]

File: Actuators.kicad_sch Sheet: /Actuators/ HAN
