EmielV2002/FRDM_MCXx_SensHat/Docs/Docs V1.x/FRDM-MCXx_Shield_V1.2.pdf

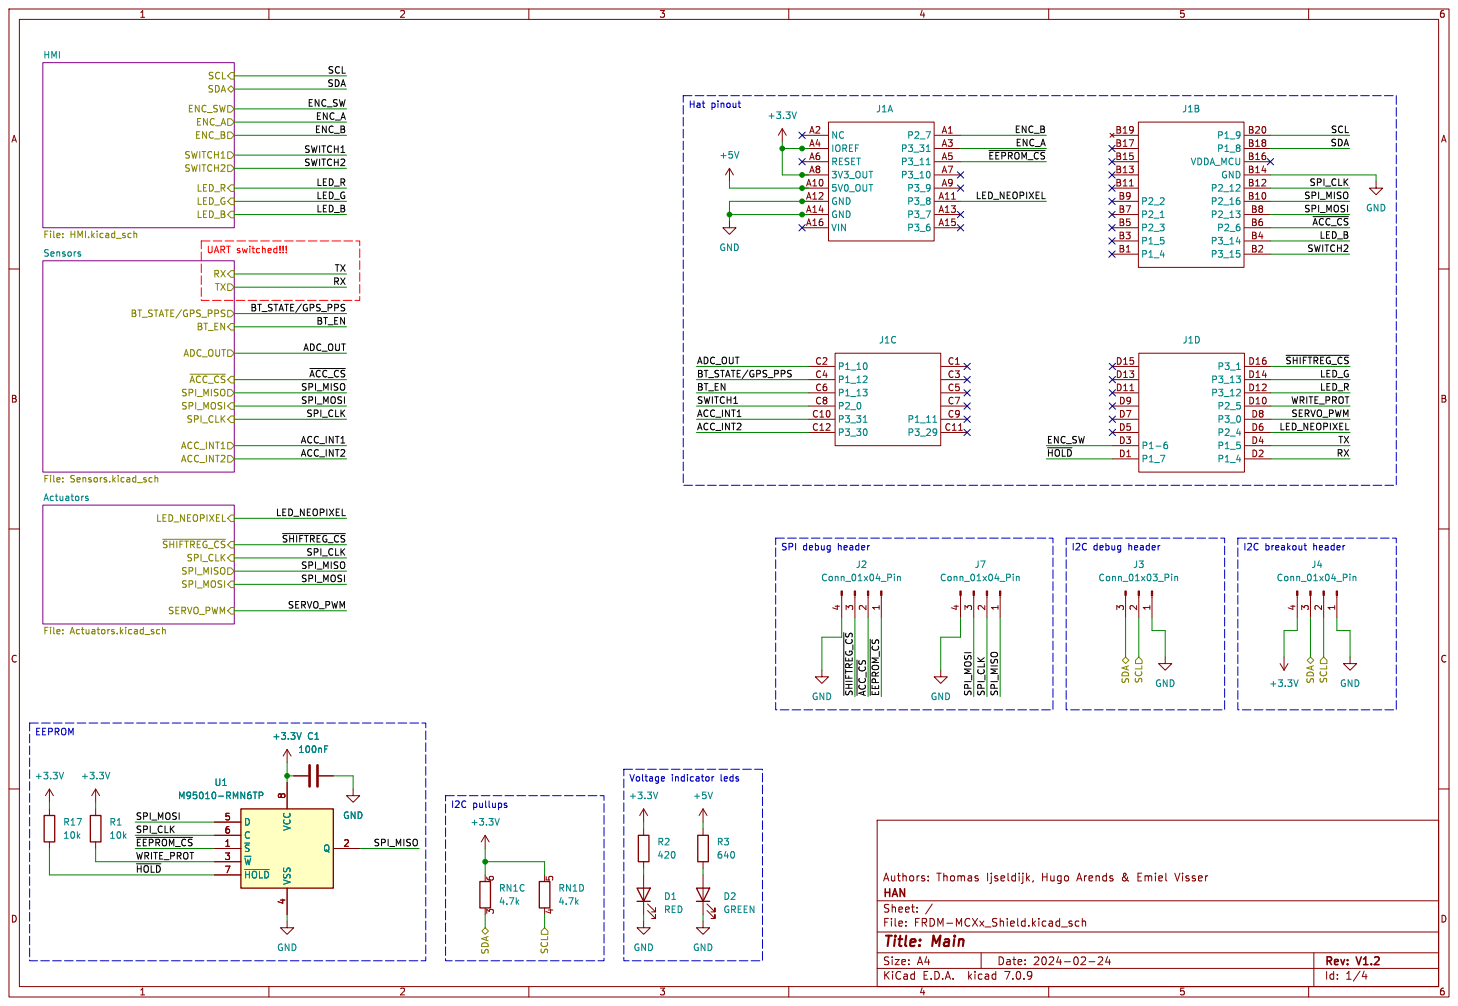
[picture p28: page 1]

File: FRDM-MCXx_Shield.kicad_sch Sheet: / HAN

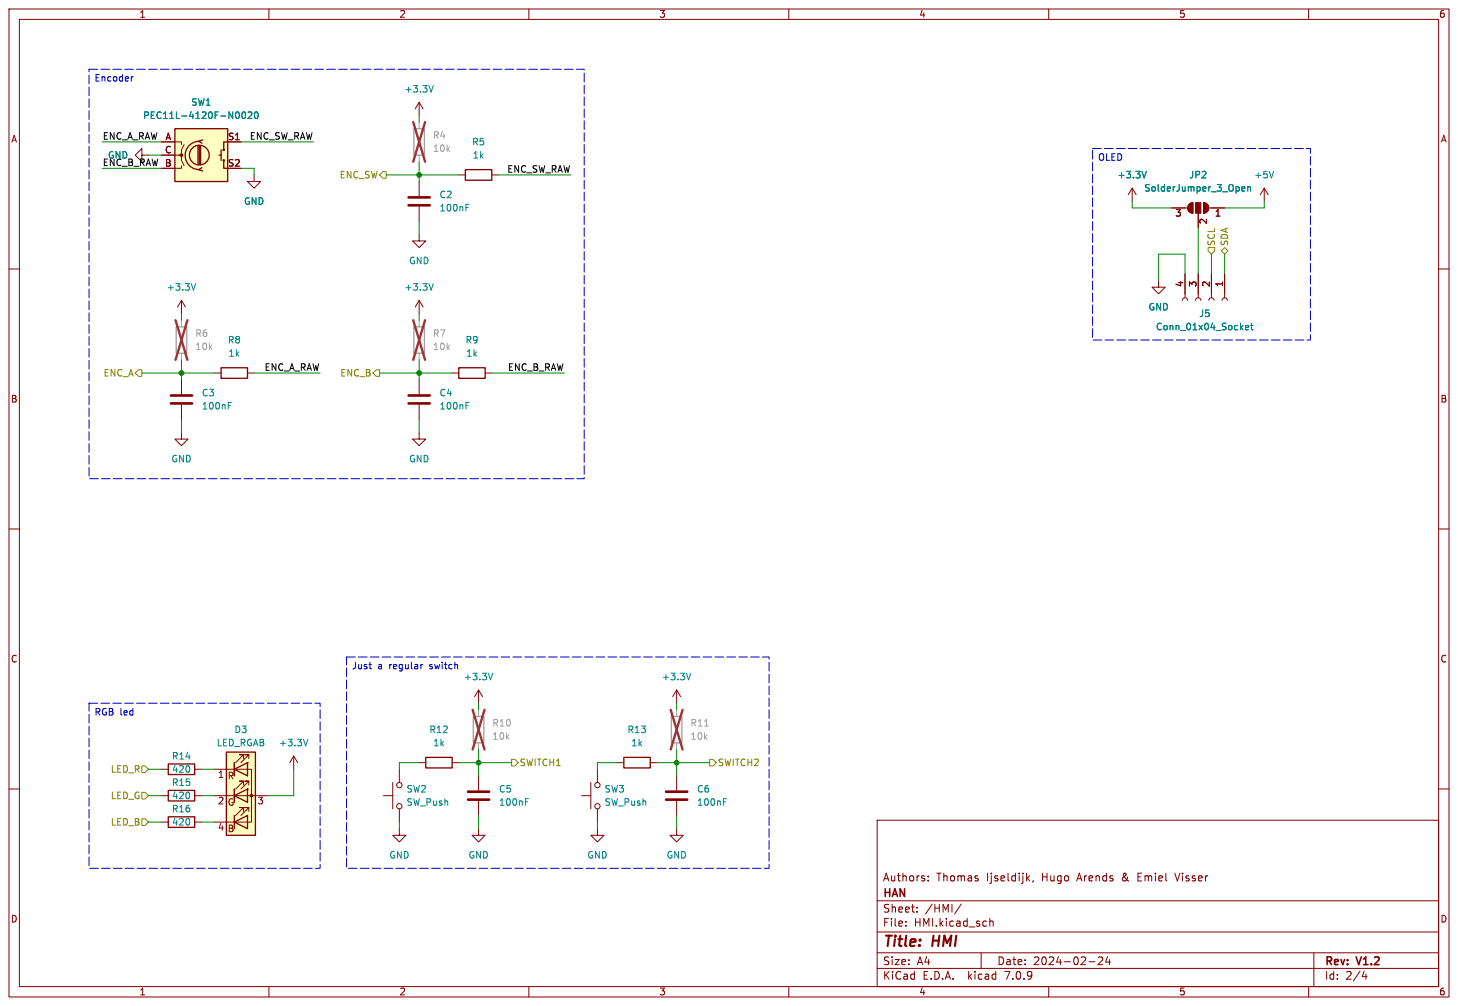
[picture p29: page 2]

Id: 2/4 Title: HMI File: HMI.kicad_sch Sheet: /HMI/ HAN

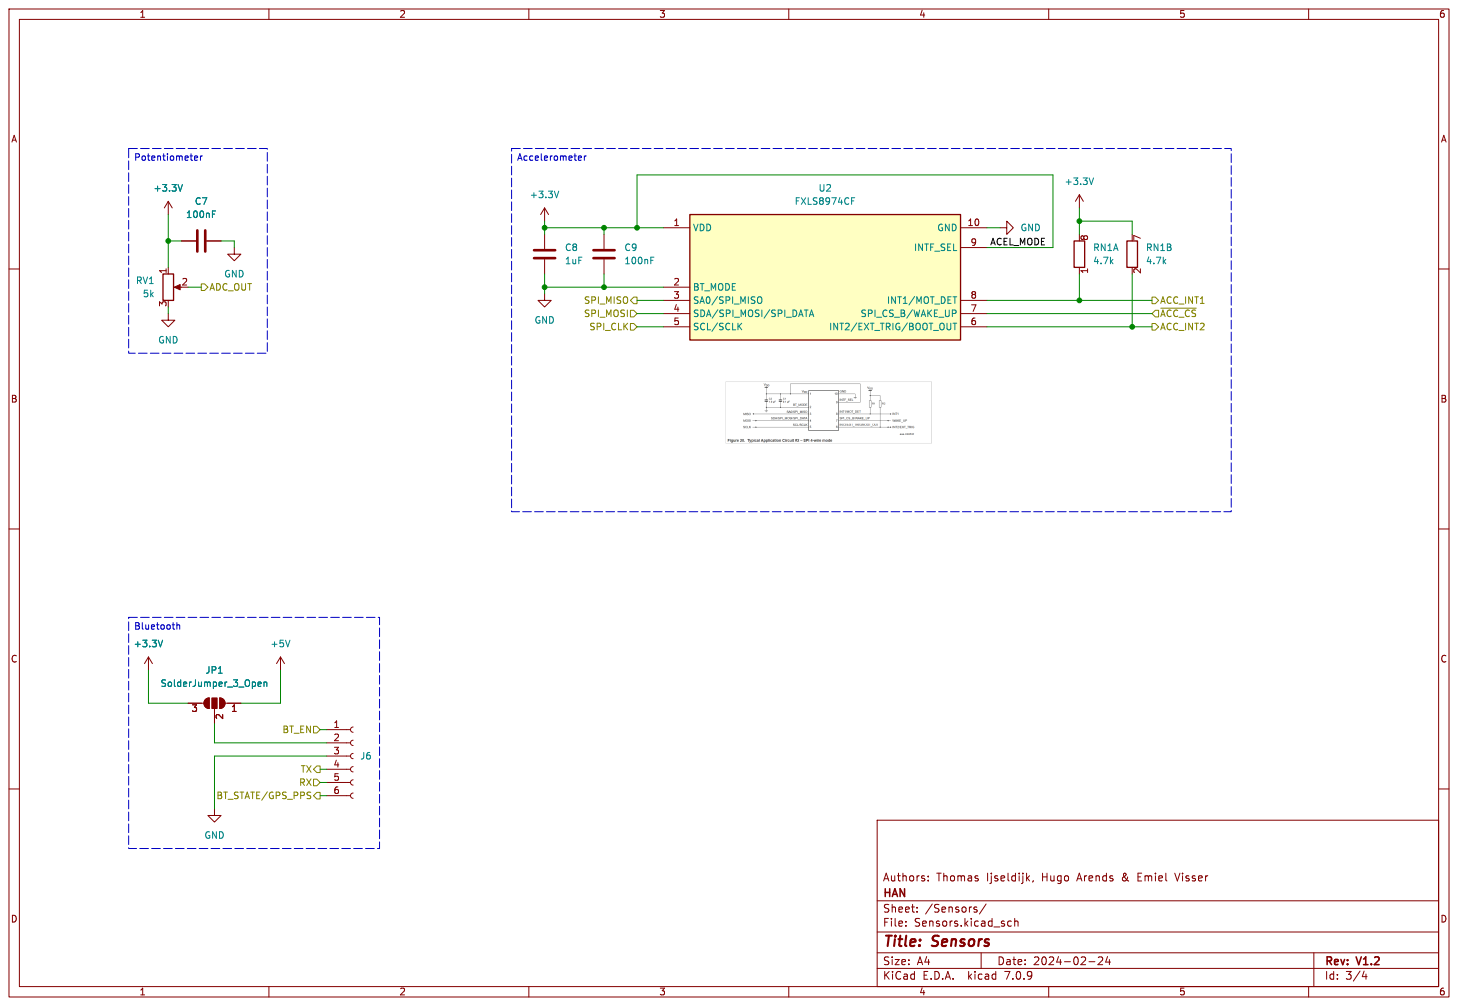
[picture p30: page 3]

File: Sensors.kicad_sch Sheet: /Sensors/ HAN

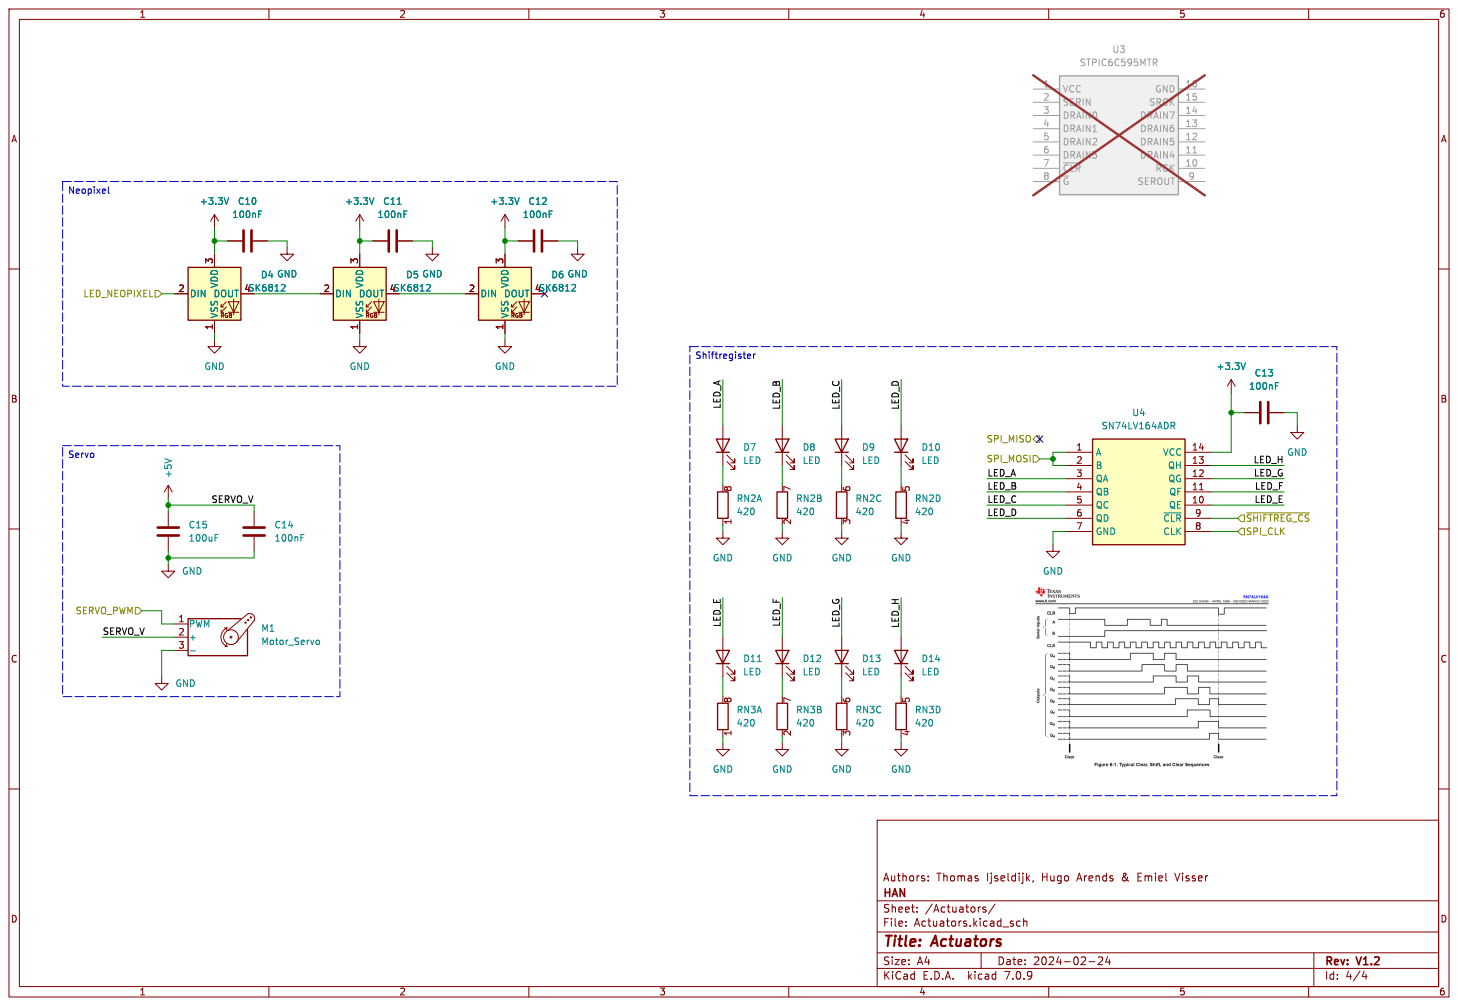
[picture p31: page 4]

File: Actuators.kicad_sch Sheet: /Actuators/ HAN
