EmielV2002/FRDM_MCXx_SensHat/Docs/Docs V1.x/FRDM-MCXx_Shield_V1.3.pdf

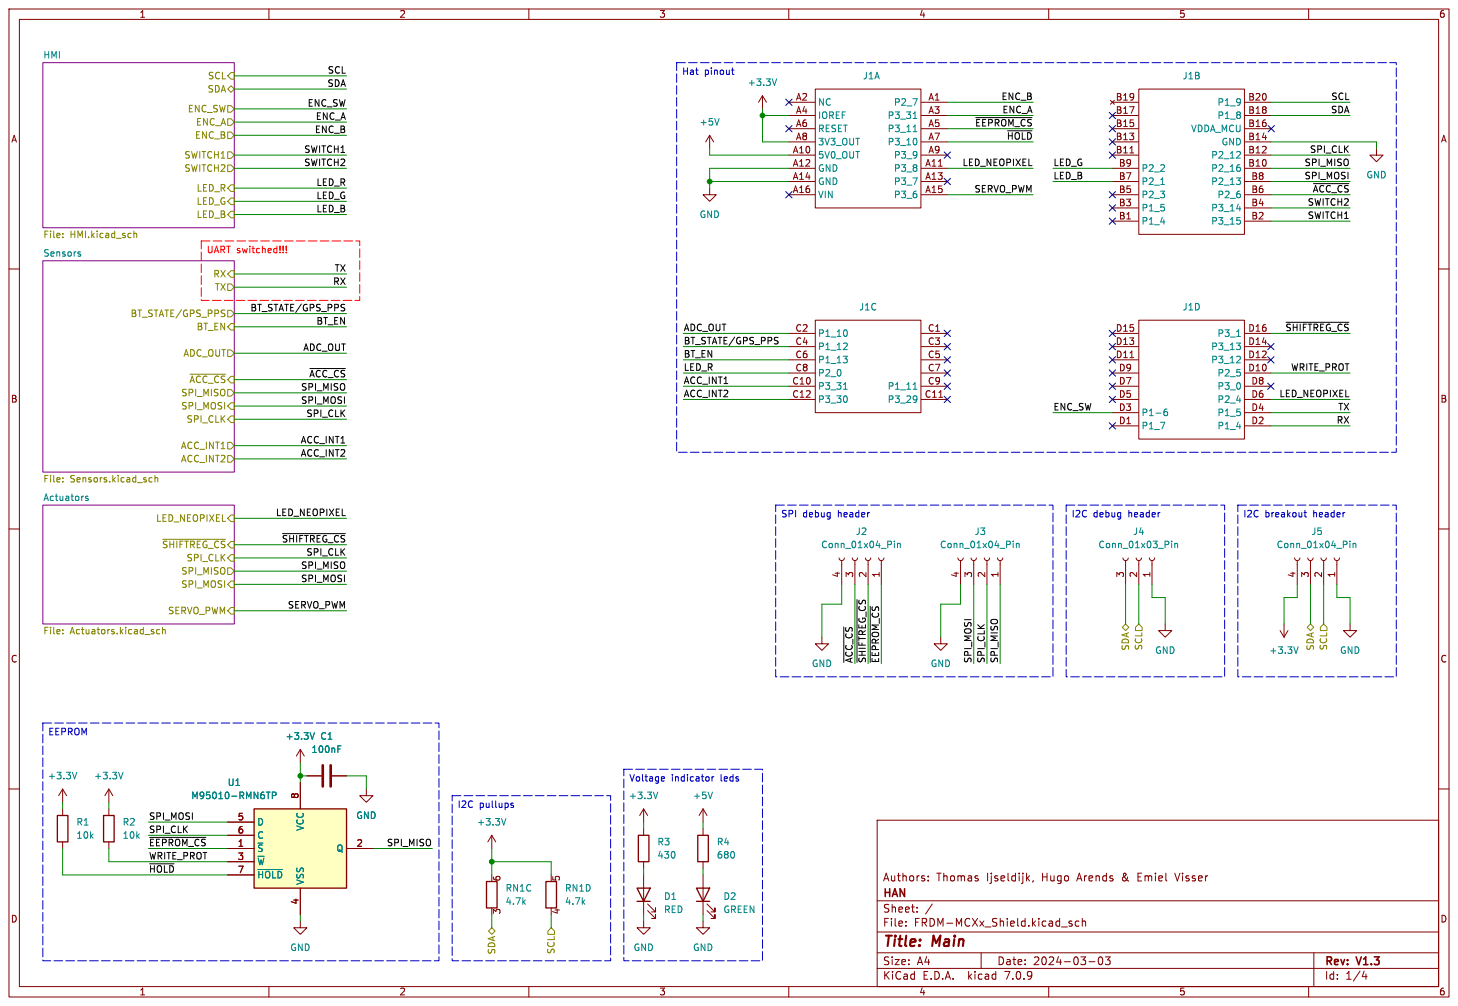
[picture p32: page 1]

File: FRDM-MCXx_Shield.kicad_sch Sheet: / HAN

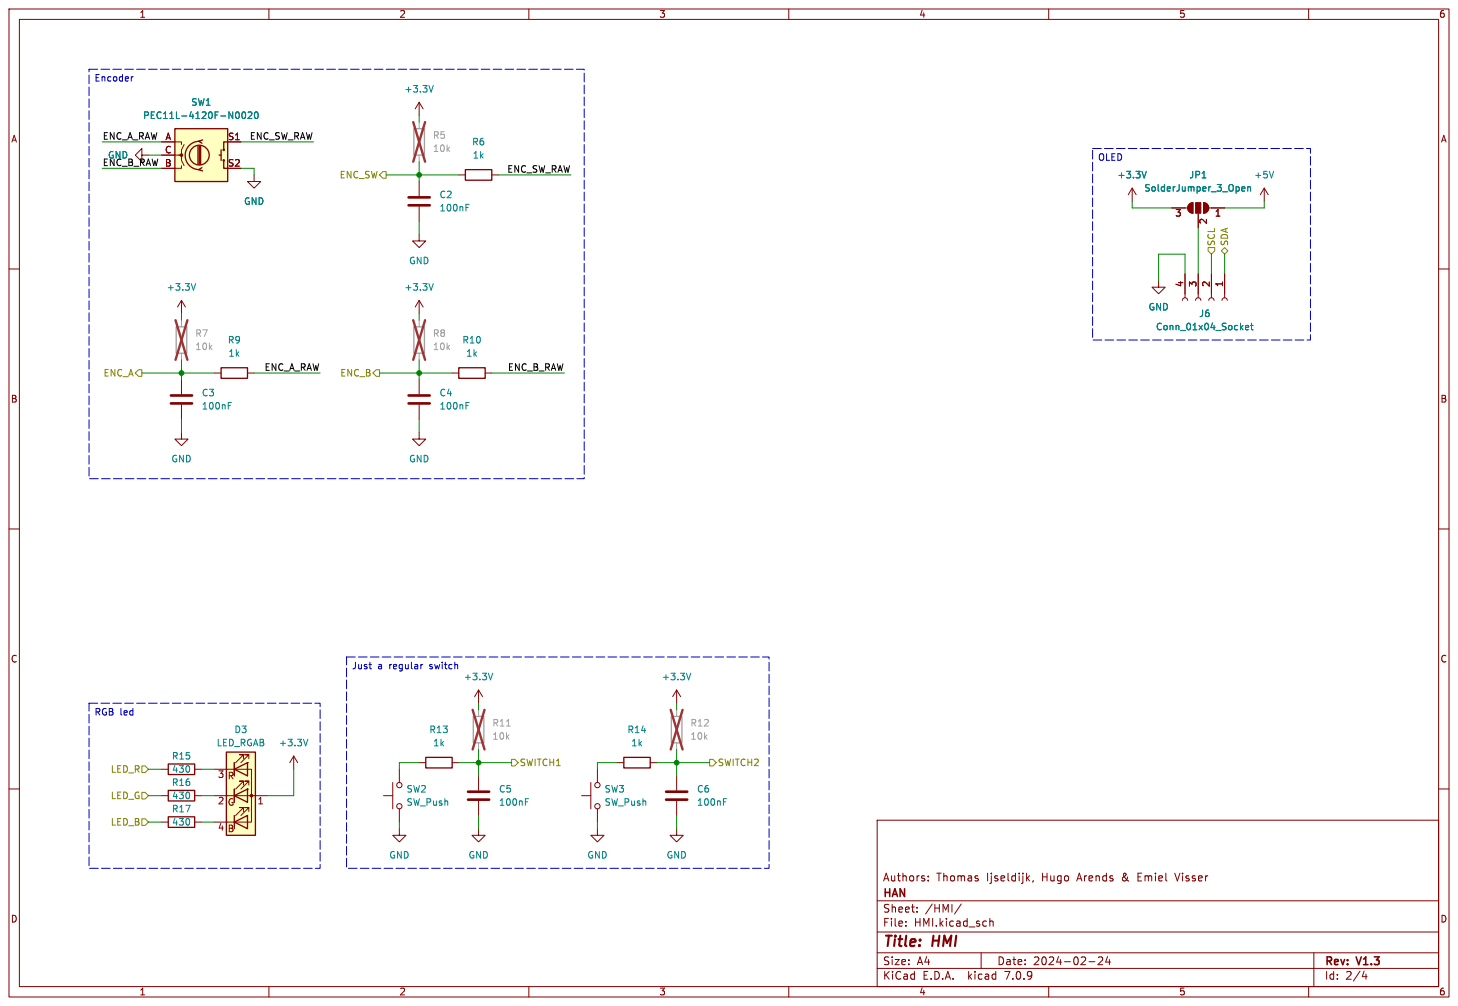
[picture p33: page 2]

Just a regular switch RGB led

Id: 2/4 Title: HMI File: HMI.kicad_sch Sheet: /HMI/ HAN

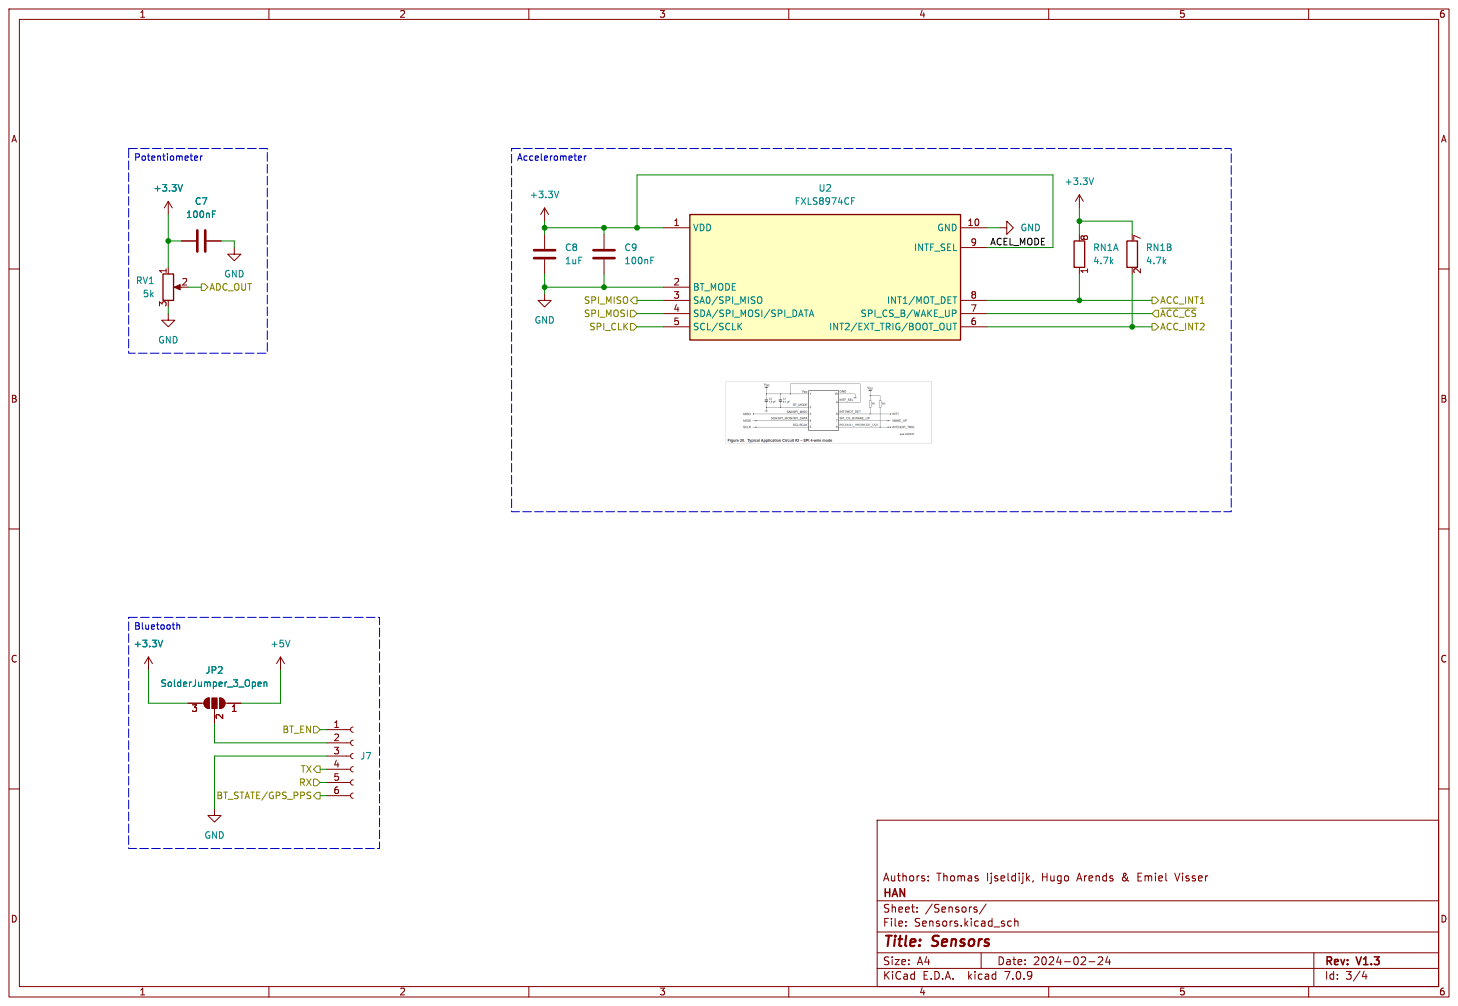
[picture p34: page 3]

File: Sensors.kicad_sch Sheet: /Sensors/ HAN

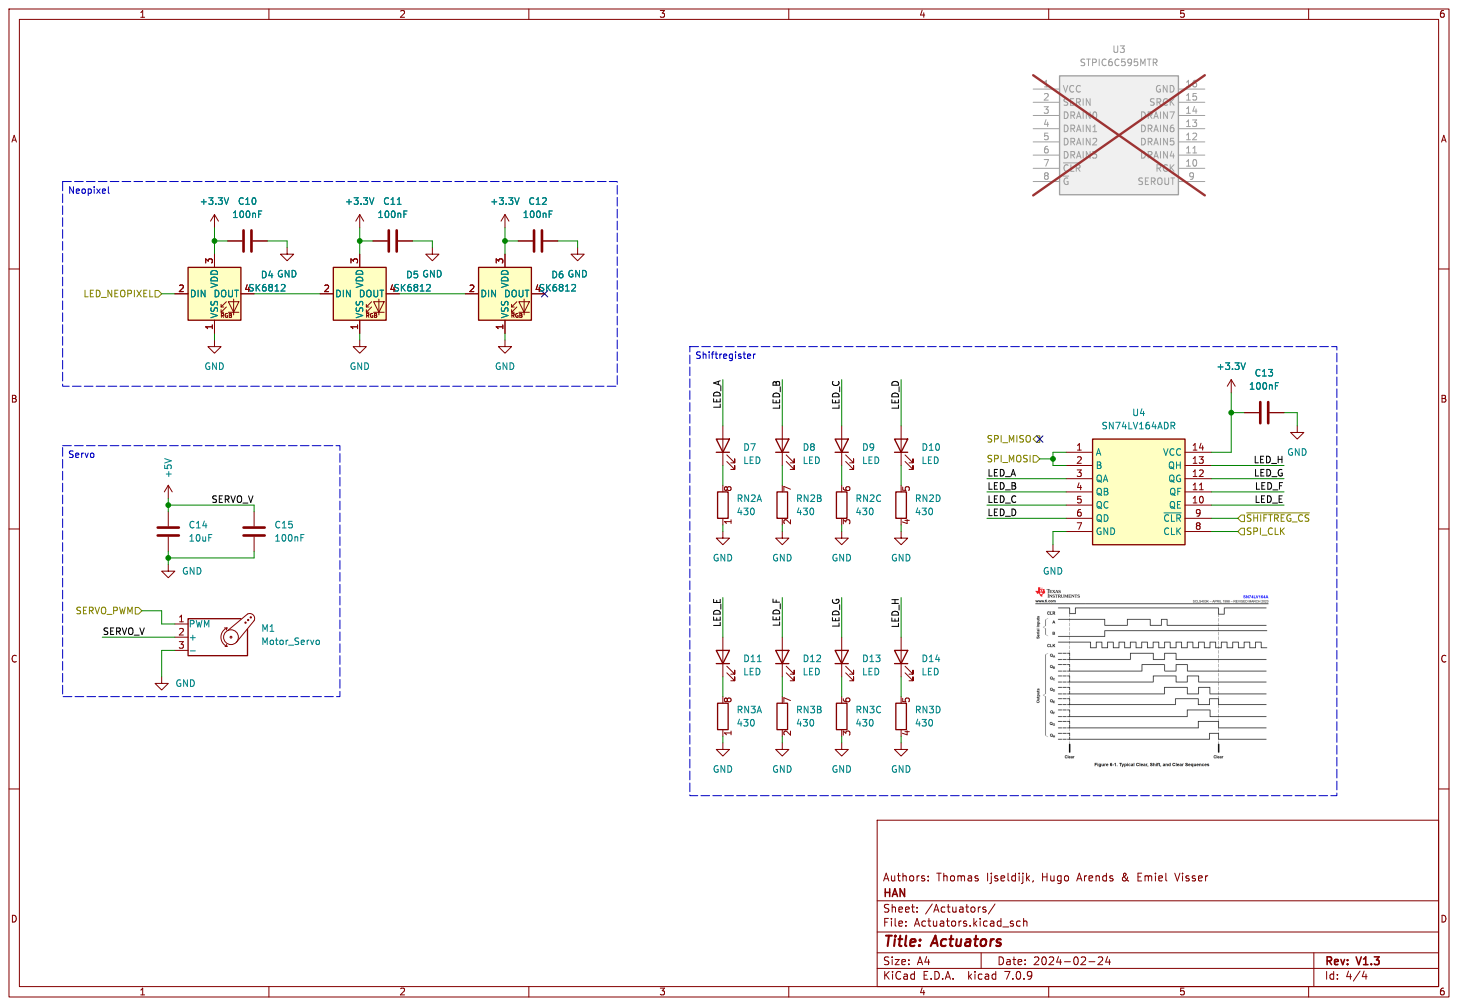
[picture p35: page 4]

File: Actuators.kicad_sch Sheet: /Actuators/ HAN
