EmielV2002/FRDM_MCXx_SensHat/Docs/Docs V2.x/FRDM-MCXx_Shield_V2.0.pdf

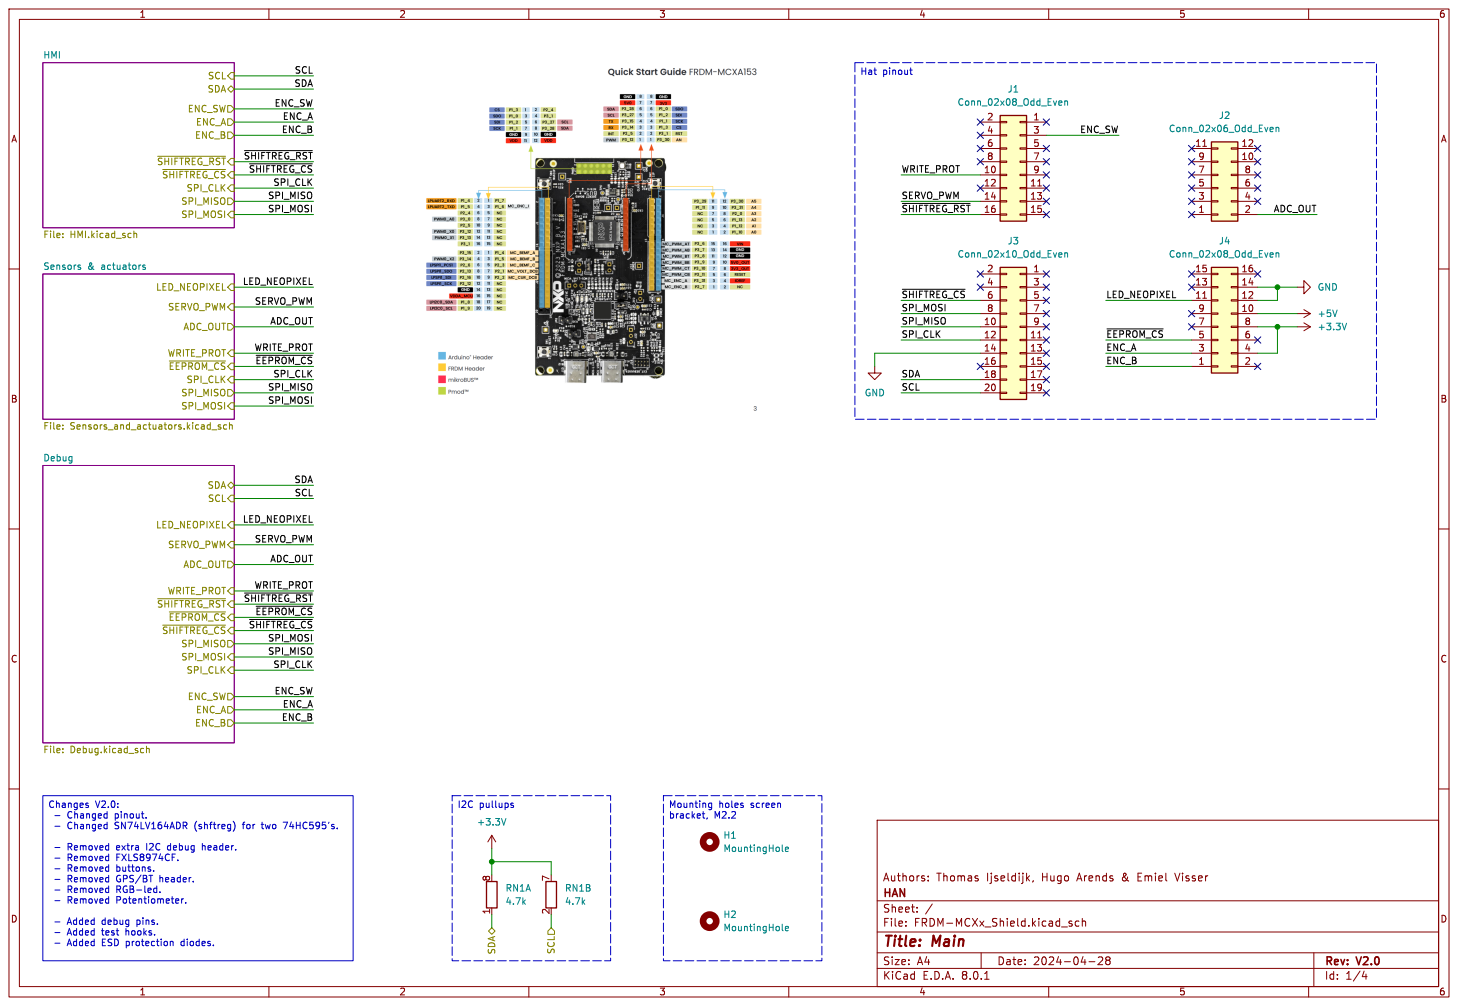
[picture p36: page 1]

Sensors & actuators File: Sensors_and_actuators.kicad_schSCL SDA

File: FRDM-MCXx_Shield.kicad_sch Sheet: / HAN

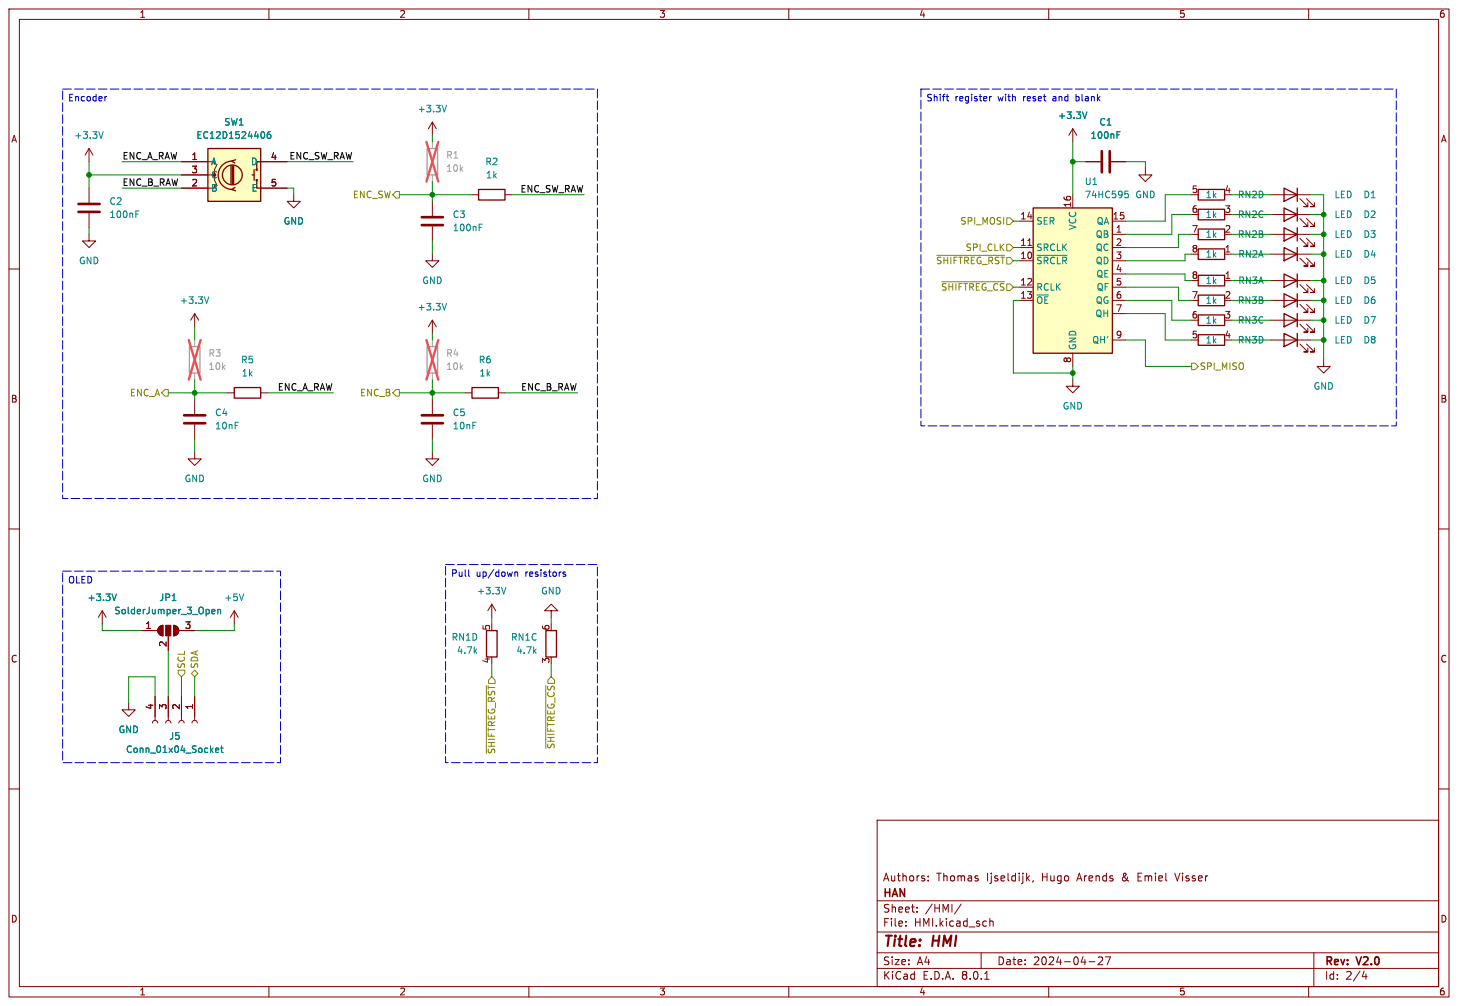
[picture p37: page 2]

Id: 2/4 Title: HMI File: HMI.kicad_sch Sheet: /HMI/ HAN


Encoder debug test points

File: Debug.kicad_sch Sheet: /Debug/ HAN


Id: 4/4 Title: Sensors & actuators
