EmielV2002/FRDM_MCXx_SensHat/(list of files, drawings)

Other design files:
PCB/FRDM-MCXA153__Shield__Template-Original/tracks/A/Altium/MCX-A153__Shield_Template.PcbDoc
PCB/FRDM-MCXA153__Shield__Template-Original/tracks/A/Altium/MCX-A153__Shield_Template.PrjPcb
PCB/FRDM-MCXA153__Shield__Template-Original/tracks/A/Altium/MCX-A153__Shield_Template.SchDoc
