EmielV2002/FRDM_MCXx_SensHat/(commit log)

2024-02-02 Add hardware schematic
2024-02-03 Add hat template
    [MCX-A153_Shield_Template.kicad_pcb, MCX-A153_Shield_Template.kicad_sch, MCX-A153__Shield_Template.PcbDoc, MCX-A153__Shield_Template.PrjPcb, MCX-A153__Shield_Template.SchDoc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]
2024-02-05 Updated hardware schematic
2024-02-05 Add base KiCad project
    [FRDM-MCXx_Shield.kicad_pcb, FRDM-MCXx_Shield.kicad_sch]
2024-02-05 Initial start on PCB schematic
    [Actuators.kicad_sch, FRDM-MCXx_Shield.kicad_sch, HMI.kicad_sch, Sensors.kicad_sch]
2024-02-06 Updated schematic
    [Actuators.kicad_sch, FRDM-MCXx_Shield.kicad_pcb, FRDM-MCXx_Shield.kicad_sch, HMI.kicad_sch, Sensors.kicad_sch]
2024-02-07 Update schematic and footprint
    [Actuators.kicad_sch, FRDM-MCXx_Shield.kicad_pcb, FRDM-MCXx_Shield.kicad_sch, HMI.kicad_sch, Sensors.kicad_sch]
2024-02-08 Updated schematic and PCB
    [3386P.step, Actuators.kicad_sch, FRDM-MCXx_Shield.kicad_pcb, FRDM-MCXx_Shield.kicad_sch, Rotary Encoder.step, SHT31_DFN8.stp, Sensors.kicad_sch]
2024-02-09 Updated schematic and PCB files
    [Actuators.kicad_sch, FRDM-MCXx_Shield.kicad_pcb, FRDM-MCXx_Shield.kicad_sch, HMI.kicad_sch, Sensors.kicad_sch]
2024-02-10 Updated PCB
    [FRDM-MCXx_Shield.kicad_pcb, Sensors.kicad_sch]
2024-02-22 Update
    Schematic: Fixed pinout, removed 5-9vin and a bunch of other stuff. Changed button/encoder debouncing.
    PCB: Fixed pinout, layout and labeling. Added extra resisitors and capacitors.
    Added diode direction markers.
    [Actuators.kicad_sch, FRDM-MCXx_Shield.kicad_pcb, FRDM-MCXx_Shield.kicad_sch, HMI.kicad_sch, Sensors.kicad_sch]
2024-02-22 Some more label changes
    [FRDM-MCXx_Shield.kicad_pcb]
2024-02-22 Added schematic pdf
2024-02-24 Updated footprint, PCB and schematic
    [Actuators.kicad_sch, FRDM-MCXx_Shield.kicad_pcb, FRDM-MCXx_Shield.kicad_sch, HMI.kicad_sch, Sensors.kicad_sch]
2024-02-26 Latest PCB version
    [FRDM-MCXx_Shield.kicad_pcb, bom.csv, designators.csv, positions.csv]
2024-02-28 Updated PCB and added bill of materials
    [Actuators.kicad_sch, Bestellijst_FRDM-MCXx_Shield.xlsx, FRDM-MCXx_Shield.kicad_pcb, FRDM-MCXx_Shield.kicad_sch, HMI.kicad_sch, Sensors.kicad_sch, bom.csv, designators.csv]
2024-03-01 Updated gerbers
    [Bestellijst_FRDM-MCXx_Shield.xlsx]
2024-03-03 Updated trace spacing and pinout
    [Actuators.kicad_sch, FRDM-MCXx_Shield.kicad_pcb, FRDM-MCXx_Shield.kicad_sch, HMI.kicad_sch, Sensors.kicad_sch, bom.csv, designators.csv, positions.csv]
2024-03-03 Cleaned up repo
    [MCX-A153_Shield_Template.kicad_pcb, MCX-A153_Shield_Template.kicad_sch, MCX-A153__Shield_Template.PcbDoc, MCX-A153__Shield_Template.PrjPcb, MCX-A153__Shield_Template.SchDoc, Orderlist_FRDM-MCXx_Shield.xlsx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]
2024-04-27 Updated V2.0
    [Actuators.kicad_sch, Debug.kicad_sch, FRDM-MCXx_Shield.kicad_pcb, FRDM-MCXx_Shield.kicad_sch, FRDM-MCXx_Shield_V1.3.kicad_pcb, FRDM-MCXx_Shield_V1.3.kicad_sch, HMI.kicad_sch, Sensors.kicad_sch]
2024-04-29 Committed latest changes
    [FRDM-MCXx_Shield.kicad_pcb, FRDM-MCXx_Shield.kicad_sch, HMI.kicad_sch]
2024-04-29 Added updated schematic
2024-04-29 Fixed labeling
    [Debug.kicad_sch, FRDM-MCXx_Shield.kicad_pcb, FRDM-MCXx_Shield.kicad_sch, HMI.kicad_sch, Sensors_and_actuators.kicad_sch]
2024-04-30 Added renders
    [FRDM-MCXx_Shield.kicad_pcb]
2024-05-03 Added PDF of schematic
    [FRDM-MCXx_Shield.kicad_sch]
2024-05-20 Updated labeling and header positions
    [Debug.kicad_sch, FRDM-MCXx_Shield.kicad_pcb, FRDM-MCXx_Shield.kicad_sch]
2024-05-20 Added I2C header labels
    [FRDM-MCXx_Shield.kicad_pcb]
2024-05-22 removed QR code
    [FRDM-MCXx_Shield-B_Cu.gbr, FRDM-MCXx_Shield-B_Mask.gbr, FRDM-MCXx_Shield-B_Paste.gbr, FRDM-MCXx_Shield-B_Silkscreen.gbr, FRDM-MCXx_Shield-Edge_Cuts.gbr, FRDM-MCXx_Shield-F_Cu.gbr, FRDM-MCXx_Shield-F_Mask.gbr, FRDM-MCXx_Shield-F_Paste.gbr]
2024-05-22 Added gerbers
2024-05-22 Add order lists
    [Bestellijst_FRDM-MCXx_Shield_V1.2.xlsx, Orderlist_FRDM-MCXx_Shield_V2.0.xlsx]
2024-05-25 Added easteregg
    [FRDM-MCXx_Shield.kicad_pcb]
2024-06-13 Added V3
    [Debug.kicad_sch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]
2024-06-17 Updated V3.0
    [Debug.kicad_sch, FRDM-MCXx_Shield.kicad_pcb, FRDM-MCXx_Shield.kicad_sch, HMI.kicad_sch, Sensors_and_actuators.kicad_sch]
2024-06-17 Some housekeeping
    [Bestellijst_FRDM-MCXx_Shield_V1.2.xlsx, Debug.kicad_sch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]
2024-06-17 Added testcode (TO BE REMOVED)
    [3386P.step, Actuators.kicad_sch, FRDM-MCXx_Shield.kicad_pcb, FRDM-MCXx_Shield.kicad_sch, HMI.kicad_sch, Rotary Encoder.step, SHT31_DFN8.stp, Sensors.kicad_sch]
2024-06-18 Updated labeling. removed code
    [3386P.step, Actuators.kicad_sch, FRDM-MCXx_Shield.kicad_pcb, FRDM-MCXx_Shield.kicad_sch, FRDM-MCXx_Shield_V3.0.kicad_pcb, HMI.kicad_sch, Rotary Encoder.step, SHT31_DFN8.stp]
2024-06-18 Added BOM for V3.0
    [Orderlist_FRDM-MCXx_Shield_V3.0.xlsx]
2024-06-19 Added R7
    [Debug.kicad_sch, FRDM-MCXx_Shield_V3.0.kicad_pcb, FRDM-MCXx_Shield_V3.0.kicad_sch, HMI.kicad_sch, Orderlist_FRDM-MCXx_Shield_V3.0.xlsx, Sensors_and_actuators.kicad_sch]
2024-06-20 Added solder stencil tool
    [Stencil.SLDPRT, Tool.SLDPRT, Tool.STL, tool assem.SLDASM]
2024-06-22 Updated assembly
    [FRDM-MCXx_Shield_V3.0.kicad_pcb, HMI.kicad_sch, tool assem.SLDASM]
